Umair-Coder124/RoverBuddy-X1-verified/README.md

# RoverBuddy X1

RoverBuddy X1 is a design for a camera-guided companion robot. Four mecanum wheels let it drive sideways as well as forward and backward. A camera in the moving head is intended to track a person, and the chest display is intended to show status. The project combines computer vision, motion control and a custom chassis.

## CAD

[Open the latest Onshape revision](https://cad.onshape.com/documents/7af13938ef1c0698d1f50b49/w/3e6d69d20d18f8a901bda826/e/d6c90a986fc1453722e99382)

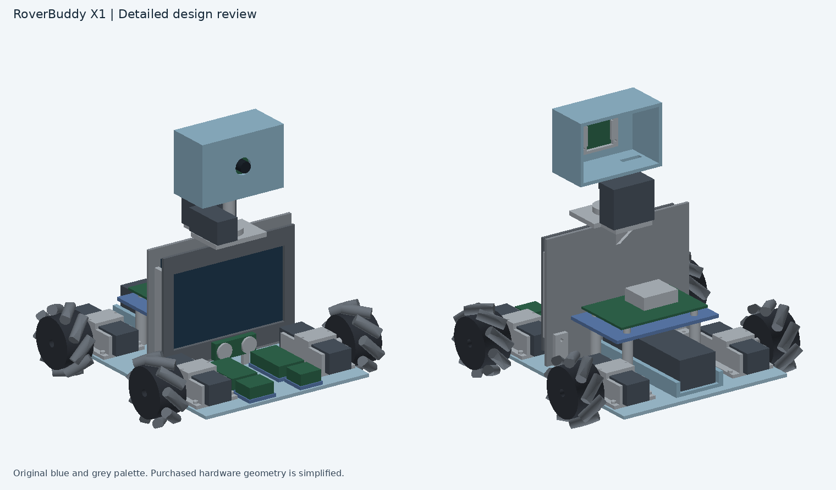
[picture p1: cad/Assembly_Preview.png]
Full CAD assembly from two angles


The [CAD notes](cad/README.md) describe the wheel and motor mounts, camera carrier and electronics placement. The full assembly STEP and 131 individual STEP files are in [cad](cad/). Purchased component envelopes are identified in the [parts manifest](cad/Parts_Manifest.csv). The STEP revision replaces `Roller_Rear_L_03` and `Roller_Front_R_03` with simplified representations of the purchased wheel rollers. The repaired import opened without the previously reported warnings in the project owner’s Onshape session. Hardware fit still needs confirmation.

## Wiring and intended use

```mermaid
flowchart LR
    BAT["3S battery"] --> PROT["Main fuse, disconnect and undervoltage protection"]
    PROT --> AUX["Separate Pi and servo supplies"]
    PROT --> STOP["Hardware motor cutoff"]
    STOP --> MOTOR["Independent front and rear 6 V motor supplies"]
```

Sophia confirmed that a wiring diagram is acceptable for this module-based design. See the [wiring draft](docs/WIRING.md) and [firmware instructions](firmware/README.md). Use the firmware simulator to try the drive logic. The intended physical workflow is to select a target through the camera system, then use the controller to command the four motors. Hardware testing and an end-to-end follow mode are pending.

## Design submission readiness

The drive controller passed five desktop tests and a simulated watchdog stop. The [serial parser fix](https://github.com/Umair-Coder124/RoverBuddy-X1-verified/commit/4406fdf8919625282004607cfbc282fbfebdae76) also passed a desktop check that an oversized line is discarded and the next valid line is accepted. Motor outputs are disabled by default.

- [x] Repaired Onshape tab loaded and rotated via the public link (confirmed by the project owner).
- [x] Check raised head and camera geometry against the imported pan-actuator envelope through ±180° in a separate CAD study. See the [fit result](docs/WIRING.md#raised-pan-adapter-fit-study).
- [ ] Finalize the shaft coupling and tilt mount, then check fastener access, connector clearance and camera ribbon travel in the assembled layout.
- [ ] Finalize the battery disconnect, hardware motor cutoff, fuse and servo supply ratings. Update the wiring and BOM together.
- [x] Reconcile the priced BOM lines to the provisional subtotal.
- [ ] Add exact links and costs for the selected power-protection hardware, identify the owned screwdrivers if possible, and confirm delivered costs.
- [ ] Confirm which AI-assisted CAD and firmware files, if any, Fallen accepts in the actual design submission. The organizer feedback reported so far addressed the wiring diagram and rollers.

## BOM and submission

The [Fallen BOM](bom.csv) requests **US$1,225.67** for 52 priced lines, including two matching batteries and one balance charger. Unit prices were converted at 3.75 SAR per USD and rounded before calculating line totals. The second battery is an offboard spare. The import excludes owned tools, parts included in other purchases, unpriced power-protection hardware and delivery. The [original cost estimates and item notes](https://github.com/Umair-Coder124/RoverBuddy-X1-verified/blob/92e4858a3a350e913623ddc59bf6ecd8bff52750/bom.csv) retain the SAR prices and pending items. Confirm pricing, stock and shipping before ordering. Battery protection, hardware isolation and bench validation remain open.

This is a review package with AI-assisted reference material. The [Fallen submission guide](https://fallen.hackclub.com/docs/submitting) calls for a finished entrant-designed digital project at the funding stage. Untested firmware is acceptable at that stage, and the physical build and demo are assessed at the build stage. Fallen's rules require entrants to design and document their own work. Ask the organizers whether any reference material can be reused, complete and document your own work, and check the submission requirements before sending the project for review.
