Umair-Coder124/RoverBuddy-X1-verified/cad/Drive_Corner.png

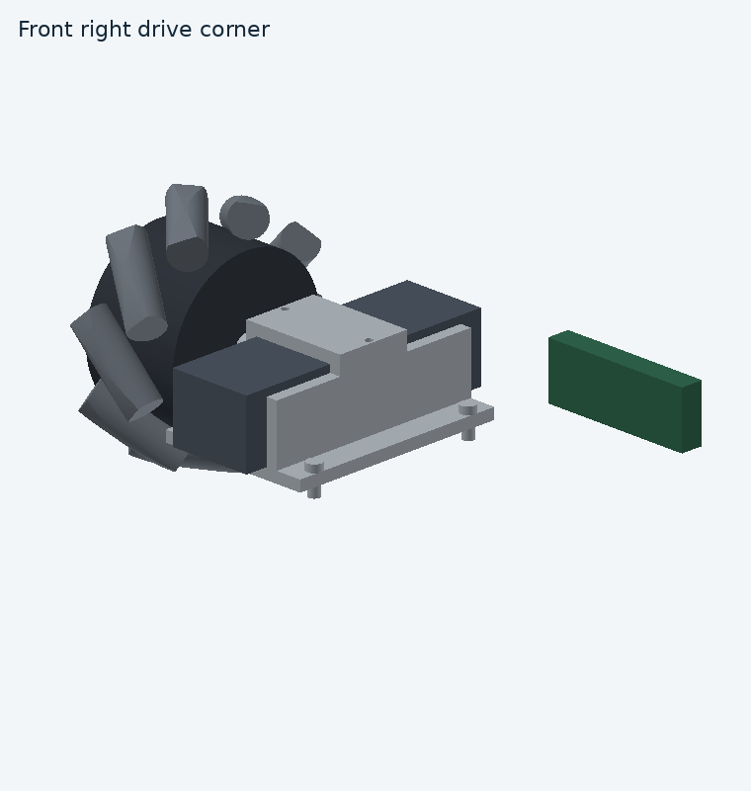
cad/Drive_Corner.png
