Umair-Coder124/RoverBuddy-X1-verified/cad/Head_Camera.png

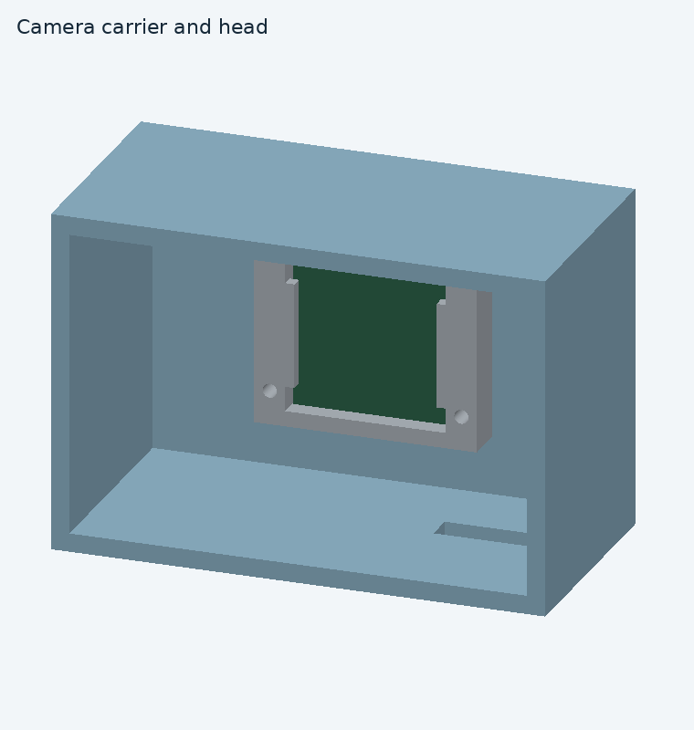
cad/Head_Camera.png
