Umair-Coder124/RoverBuddy-X1-verified/bom.csv

Item | Quantity | Unit Price | Total | Link | Description
Raspberry Pi 5 4GB kit incl official 27W PSU, active cooler, HDMI lead and case | 1 | 175.81 | 175.81 | https://geeksvalley.com/product/raspberry-pi-5-4gb-kit/ | Pi computer for on-device AI; official PSU for mains testing; included cooler and HDMI cable avoid duplicate funding.
SanDisk Extreme A2 microSDXC 64GB SDSQXAH-064G-GN6MN | 1 | 36.83 | 36.83 | https://pcpark.sa/en/collections/flash/products/sandisk-sdsqxah-064g-gn6mn | Operating system and camera software; no reliable in-stock exact product page verified
Raspberry Pi Pico 2 with Headers (SC1632) | 1 | 6.00 | 6.00 | https://www.digikey.com/en/products/detail/raspberry-pi/SC1632/26241102 | Controller with manufacturer-documented pinout
USB-A to Micro-B USB 2.0 data cable 0.5 m | 1 | 2.67 | 2.67 | https://ielectrony.com/en/product/micro-usb-cable-0-5m/ | Pi-to-Pico USB data and controller programming
Raspberry Pi Camera Module 3, Sony IMX708, standard lens | 1 | 52.00 | 52.00 | https://saudi.microless.com/product/raspberry-pi-camera-module-3-standard-sony-imx708-sensor-11-9mp-resolution-7-4mm-sensor-diagonal-f-1-8-aperture-phase-dete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 | People tracking and obstacle perception in head
Pi 5 camera cable 22pin-to-15pin 300mm | 1 | 8.00 | 8.00 | https://ielectrony.com/en/product/official-raspberry-pi-csi-fpc-flexible-cable-300mm-22pin-to-15pin-camera-cable/ | Required Pi 5 adapter ribbon; only buy 300mm if measured head-to-Pi routing fits
Waveshare 20109 5inch HDMI LCD (H) V4 capacitive USB touch display | 1 | 50.99 | 50.99 | https://www.waveshare.com/product/5inch-hdmi-lcd-h-v4.htm | Driver-free USB touch avoids the old screen GPIO touch driver uncertainty on Pi 5; uses no GPIO for touch.
Mini external USB stereo speaker for Raspberry Pi greeting audio | 1 | 7.33 | 7.33 | https://ielectrony.com/en/product/mini-external-usb-stereo-speaker/ | Pi 5 compatible USB greeting audio; previous 3.5mm concern resolved by supplier specification.
Adafruit 3777 TT DC gearbox motor 1:48, 3-6V, supplied 200mm leads | 4 | 2.95 | 11.80 | https://www.adafruit.com/product/3777 | Four independently driven TT motors with published electrical measurements; replaces ambiguous bundled-motor claim.
Cytron MDD3A dual brushed DC motor driver, 3A continuous per channel | 2 | 9.30 | 18.60 | https://www.cytron.io/c-dc-motor/c-motor-driver/p-3amp-4v-16v-dc-motor-driver-2-channels | Replaces TB6612FNG with more continuous current margin and retains separate control for every mecanum wheel.
HC-SR04 ultrasonic obstacle sensor | 1 | 6.13 | 6.13 | https://ielectrony.com/en/product/%D8%AD%D8%B3%D8%A7%D8%B3-%D8%A7%D9%84%D8%AA%D8%B1%D8%A7-%D8%B3%D9%88%D9%86%D9%8A%D9%83-hc-sr04/ | Forward distance sensing
1kΩ 1/4W 1% resistor for HC-SR04 ECHO 5V-to-3.3V divider | 1 | 0.13 | 0.13 | https://ielectrony.com/en/product/%D8%B9%D8%AF%D8%AF-1-%D9%85%D9%82%D8%A7%D9%88%D9%85%D8%A9-1k-ohm-1-4w/ | Prevent 5V ultrasonic echo damaging 3.3V logic; resistor pair only (avoid I2C-only level shifter)
2kΩ 1/4W 1% resistor for HC-SR04 ECHO 5V-to-3.3V divider | 1 | 0.13 | 0.13 | https://ielectrony.com/en/product/%D8%B9%D8%AF%D8%AF-1-%D9%85%D9%82%D8%A7%D9%88%D9%85%D8%A9-2k-ohm-1-4w/ | Prevent 5V ultrasonic echo damaging 3.3V logic; resistor pair only (avoid I2C-only level shifter)
DFRobot FIT0765 black 60mm LEFT mecanum wheel with coupling | 2 | 6.90 | 13.80 | https://www.dfrobot.com/product-2268.html | Separate wheel selection removes ambiguous bundle contents; hardware roller layout must follow maker diagram.
DFRobot FIT0766 black 60mm RIGHT mecanum wheel with coupling | 2 | 6.90 | 13.80 | https://www.dfrobot.com/product-2269.html | Four total mecanum wheels, two handed pairs, not four identical wheels.
One aluminium 2-axis standard-servo pan/tilt bracket kit incl pivot bearing and metal fittings | 1 | 17.33 | 17.33 | https://www.mikroelectron.com/product/me-603 | All-metal load-bearing bracket and supported pivot; metal gears alone do not mean all-metal servo housing.
TD8120MG 20kg.cm 180° positional high-torque servo for PAN | 1 | 18.40 | 18.40 | https://qariya.net/en/product/servo-motor-20kg-torque-td8120mg-tiankongrc-180-degree/ | Strong metal-geared servo; rotates whole head left/right
TD8120MG 20kg.cm 180° positional high-torque servo for TILT | 1 | 18.40 | 18.40 | https://qariya.net/en/product/servo-motor-20kg-torque-td8120mg-tiankongrc-180-degree/ | Tilts complete head up/down
Pololu 2184 servo extension cable, 300mm, 22AWG, JR/Futaba male-female | 2 | 4.64 | 9.28 | https://www.pololu.com/product/2184/specs | Allows full head movement without straining servo wiring; verify cable flex life
25T aluminium clamp servo horn, black, ONE per servo if required | 2 | 4.00 | 8.00 | https://www.noon.com/saudi-en/25t-metal-servo-horn-compatible-with-futaba-upgrade-part-for-sakura-d4-drift-crawler-rc-cars-cnc-high-precision-aluminum-alloy-m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 | HOLD: TD8120MG spline and required bracket horn geometry not verified. 25T is a candidate, not confirmed fit. Remove duplicate cost if matching metal horns are supplied; verify ETA before order.
Venom 15190 preassembled 3S 11.1V 2200mAh 50C LiPo, UNI 2.0 adapter system | 2 | 84.00 | 168.00 | https://hobby-rc.net/product/بطارية-venom-50c-3s-2200mah-11-1v-lipo/ | 3S gives headroom above Pi power board 7V minimum and 6V buck regulator dropout; avoids the old 2S low-voltage mismatch.
SkyRC S100neo SK-100202 AC/DC balance charger with storage mode | 1 | 116.53 | 116.53 | https://hobbysportzksa.com/en-sa/products/sky-rc-s100neo-ac-dc-charger-item-no-sk-100202 | Documented chemistry/cell-count support and storage function; price is higher than the unverified SAR 120 allowance.
LiPo battery storage/charging bag, flame-retardant glass-fiber pouch, 10x20cm | 1 | 7.47 | 7.47 | https://www.noon.com/saudi-en/lipo-battery-safe-bag-210d-high-grade-fire-retardant-material-explosion-proof-high-temperature-resistant-lipo-charging-sack-for-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 | Safer charging/storage with adult oversight; fireproof claims not guaranteed; verify certified seller listing
20cm reusable LiPo retention strap, TWO individual straps | 2 | 2.40 | 4.80 | https://www.pixelelectric.com/drones-parts/drone-assembly-parts/accessories/rc-battery-belt-strap-cable-tie/ | Secures pack in printed tray without crushing cells
Locking emergency-stop push button LAY37, 10A thermal rating (DC rating TBC) | 1 | 2.80 | 2.80 | https://ielectrony.com/en/product/660vac-10a-dpst-emergency-stop-push-button-switch/ | Accessible drive cutout when movement unsafe
DC-rated main power switch matched to measured maximum current | 1 | 2.67 | 2.67 | https://ielectrony.com/en/product/symfonia-ad2212-round-push-button-12v-on-off-power-switch-suitable-for-10a250vac-20a12vdc/ | Robot power isolation; verify DC interrupt rating at full pack voltage and inrush
RS PRO 237-5266 inline ATO blade fuse holder, 32V, 15A holder, 16AWG leads | 1 | 10.23 | 10.23 | https://sa.rsdelivers.com/product/rs-pro/rs-pro-15-a-in-line-fuse-holder-32-v/2375266?backToResults=1 | Protect main battery feed, place near positive terminal; source direct item page needed
Littelfuse 0287010.PXCN ATOF 10A 32VDC fuse; one installed plus one spare | 2 | 0.35 | 0.70 | https://www.digikey.com/en/products/detail/littelfuse-inc/0287010-PXCN/2519807 | Named DC fuse candidate rather than unspecified 20A fuse; protects battery feed subject to current coordination.
Yahboom YB-MPP01-V1.0 Pi 5 PD power board, 7-24V input for 5V/5A | 1 | 25.00 | 25.00 | https://geekworm.com/products/yb-mpp01 | Purpose-built Pi 5 power negotiation; no unsupported claim that any 5A USB-C lead negotiates 5V/5A.
Pololu 6V 5.5A switching regulator D36V50F6 for head servos | 1 | 39.95 | 39.95 | https://www.pololu.com/product/4092 | Separate servo 6V supply prevents Pi resets
Pololu D36V50F6 6 V regulator, one per motor driver | 2 | 39.95 | 79.90 | https://www.pololu.com/product/4092 | Independent front and rear motor rails
Safa SKU1690 XT60 male/female connector cable pair | 1 | 9.33 | 9.33 | https://www.safaelectronics.com/product/xt60-connector-with-cable-mf | Prevent reverse-polarity and allow unplugging battery; seller to confirm actual battery connector
WAGO 221-415 5-way lever connectors, one pack of 10 (use separate + and - nodes) | 1 | 17.79 | 17.79 | https://my.rs-online.com/web/p/standard-terminal-blocks/8837557 | Named insulated distribution hardware replaces unspecified bare solder bus and avoids undersized signal terminal use.
TW21 twin flexible copper PVC cable 2 x 1.0mm2, three one-metre lengths | 3 | 0.33 | 0.99 | https://ielectrony.com/product/%D8%B3%D9%84%D9%83-%D9%85%D8%B2%D8%AF%D9%88%D8%AC-%D9%85%D8%B3%D8%B7%D8%AD-%D9%88%D9%85%D8%B9%D8%B2%D9%88%D9%84-pvc-2x-1-0-mm/ | Locally listed minimum-length power wiring; verify ampacity rather than infer it from a wire size alone.
Silicone 22AWG flexible signal and motor hookup wire about 2m each color | 1 | 21.07 | 21.07 | https://ielectrony.com/en/product/22awg-6-colors-mix-kit-electrical-wire-copper-wire-for-diy/ | Low-current controller, servo signal and sensor wiring
40 x 20cm male-to-female Dupont jumper wires | 1 | 5.33 | 5.33 | https://ielectrony.com/en/product/%D8%B9%D8%AF%D8%AF-40-%D8%B3%D9%84%D9%83-%D8%B3%D9%84%D9%83-%D8%B0%D9%83%D8%B1-%D8%A7%D9%86%D8%AB%D9%89-20-%D8%B3%D9%85/ | Prototyping and controller wiring; not for high-current supply
40 x 20cm female-to-female Dupont jumper wires | 1 | 5.33 | 5.33 | https://ielectrony.com/en/product/%D8%B9%D8%AF%D8%AF-40-%D8%B3%D9%84%D9%83-%D8%A7%D9%86%D8%AB%D9%89-%D8%A7%D9%86%D8%AB%D9%89-20-%D8%B3%D9%85/ | Pico GPIO and low-current modules; not motor power
2pcs insulated 18AWG female spade terminal leads 30cm | 1 | 2.67 | 2.67 | https://ielectrony.com/en/product/6-3mm-female-spade-crimp-terminal-with-insulating-sleeve-and-300mm-red-and-black-wires/ | Power switch/stop lug wiring only if 6.3mm tab switch selected; check fit
5x7cm solderable copper prototyping perfboard | 1 | 2.27 | 2.27 | https://ielectrony.com/en/product/57-cm-universal-pcb-board/ | Mount basic signal interface and resistors (not custom MCU PCB)
Heat shrink insulation tubing 4mm x 1m | 1 | 1.20 | 1.20 | https://ielectrony.com/en/product/heat-shrink-tubing-4mm-black-1-meter/ | Insulate small solder joints
Heat shrink insulation tubing 8mm x 1m | 1 | 1.87 | 1.87 | https://ielectrony.com/en/product/heat-shrink-tubing-8mm-black-1-meter/ | Insulate large cable terminations
Nylon cable ties, 5-piece pack 292 x 3.6mm; TWO packs | 2 | 0.40 | 0.80 | https://ielectrony.com/en/product/nylon-tie-292x3-6mm/ | Cable routing away from gears/wheels
TAC Z-BG-F8 open grommet 8mm, four pieces | 4 | 0.07 | 0.28 | https://electrotel.sa/products/tac-grommet-open | Protect cables at enclosure exits; printed secured guides supply strain relief.
200-piece M3/M2.5 brass standoff / nuts / screws robot hardware kit | 1 | 15.07 | 15.07 | https://ielectrony.com/en/product/200pcs-screw-kit-for-robot-accessories/ | Includes Pi standoffs and many body fasteners; eliminates separate M2.5 and M3 assorted packs
M2x10 camera mounting screws, pack of 5; matching captive nuts INCLUDED in print-service quote request | 1 | 0.27 | 0.27 | https://ielectrony.com/en/product/m2x10-304-stainless-steel-cross-recessed-pan-head-phillips-screws-5pcs/ | Camera Module 3 uses small fasteners; confirm M2 vs M2.5 mounting hole
M3x20 stainless nonpointed bolts pack of 5 | 1 | 0.31 | 0.31 | https://ielectrony.com/en/product/m3x20-bolt-non-pointed-5pcs/ | Only if exact head/chest print mounts require 20mm thread length
PETG printing, cleanup, inserts, M2 nuts and screw-down cable guides for final verified CAD parts | 1 | 146.67 | 146.67 | https://omq3d.com/en/pricing.html | One scoped fabrication service, including fastener finishing; outsourced printing preserves custom chassis and avoids printer/filament purchase.
UNI-T UT33A+ digital multimeter | 1 | 22.67 | 22.67 | https://ielectrony.com/en/product/digital-multimeter-ut33a/ | Continuity, regulator output voltage, polarity and wiring safety
NEBCO clear OTG safety glasses, seller claims EN166 | 1 | 1.47 | 1.47 | https://nebcoksa.com/en/otg-safety-glasses/p99230678 | Eye protection during snipping/soldering; exact seller page required
30x20cm heat-insulating silicone soldering work mat | 1 | 6.67 | 6.67 | https://ielectrony.com/en/product/heat-insulation-silicone-working-mat-3020cm/ | Protect desk from hot iron; remove if a proper metal/ceramic surface already available
Compact basic 1.5mm/2mm/2.5mm/3mm Allen key set | 1 | 4.00 | 4.00 | https://ielectrony.com/product/%D9%85%D9%81%D8%A7%D8%AA%D9%8A%D8%AD-%D8%B3%D8%AF%D8%A7%D8%B3%D9%8A%D8%A9-%D8%A7%D9%84%D9%8A%D9%86/ | Fit motor/servo fasteners; user has plus/minus screwdriver only
Adjustable 60W soldering kit with iron, stand, solder, wire stripper/cutter, tips, pump, sponge and tweezers | 1 | 26.13 | 26.13 | https://ielectrony.com/en/product/useful-220v-60w-uk-plug-soldering-handy-kit/ | One inexpensive kit replaces several tools; meets Fallen minimum-tool principle.
