Umair-Coder124/RoverBuddy-X1-verified/cad/RoverBuddy_X1_Detailed_Assembly.step

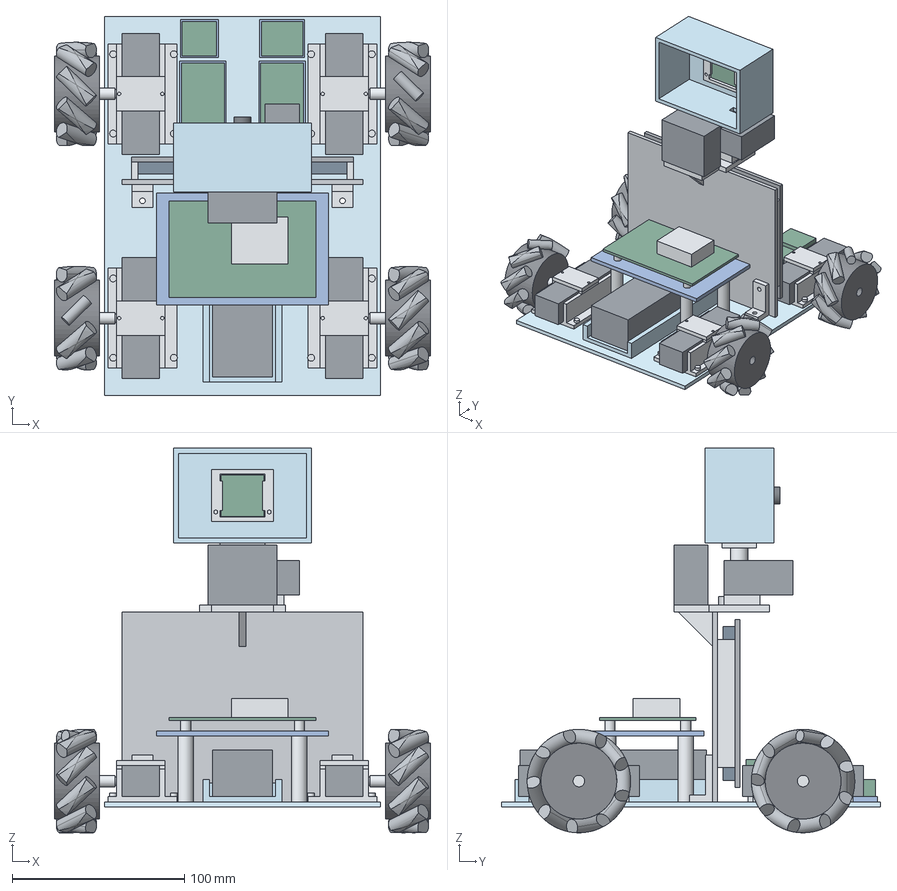
[picture p4: CAD file, 2026-11-13]
cad/RoverBuddy_X1_Detailed_Assembly.step
218.0 x 220.0 x 223.0 mm
02_Chest_Panel_140x110x3
04_Neck_Base_Plate_50x35x4
05_Single_Concept_Gusset_4mm
09_Obstacle_Sensor_Front_Reference
Ultrasonic_Transducer_-12
Ultrasonic_Transducer_12
10_Neck_Pan_Axis_Bearing_Concept
Neck_Pan_Axis_Placeholder
Cradle_Base_Screw_Front_L_39.8_42
Cradle_Base_Screw_Front_L_39.8_88
Cradle_Base_Screw_Front_L_75_42
Cradle_Base_Screw_Front_L_75_88
Motor_Cradle_Front_L
Motor_3777_Envelope_Front_L
Cradle_Cap_Post_Front_L_46.5
Cradle_Cap_Post_Front_L_71.5
Motor_Cradle_Cap_Front_L
Motor_Shaft_Reference_Front_L
Supplied_Coupling_Reference_Front_L
Mecanum_Wheel_Hub_Front_L
Roller_Front_L_01
Roller_Front_L_02
Roller_Front_L_03
Roller_Front_L_04
Roller_Front_L_05
Roller_Front_L_06
Roller_Front_L_07
Roller_Front_L_08
Roller_Front_L_09
Cradle_Base_Screw_Rear_L_39.8_-88
Cradle_Base_Screw_Rear_L_39.8_-42
Cradle_Base_Screw_Rear_L_75_-88
Cradle_Base_Screw_Rear_L_75_-42
Motor_Cradle_Rear_L
Motor_3777_Envelope_Rear_L
Cradle_Cap_Post_Rear_L_46.5
Cradle_Cap_Post_Rear_L_71.5
Motor_Cradle_Cap_Rear_L
Motor_Shaft_Reference_Rear_L
Supplied_Coupling_Reference_Rear_L
Mecanum_Wheel_Hub_Rear_L
Roller_Rear_L_01
Roller_Rear_L_02
Roller_Rear_L_03
Roller_Rear_L_04
Roller_Rear_L_05
Roller_Rear_L_06
Roller_Rear_L_07
Roller_Rear_L_08
Roller_Rear_L_09
Cradle_Base_Screw_Front_R_39.8_42
Cradle_Base_Screw_Front_R_39.8_88
Cradle_Base_Screw_Front_R_75_42
Cradle_Base_Screw_Front_R_75_88
Motor_Cradle_Front_R
Motor_3777_Envelope_Front_R
Cradle_Cap_Post_Front_R_46.5
Cradle_Cap_Post_Front_R_71.5
Motor_Cradle_Cap_Front_R
Motor_Shaft_Reference_Front_R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
