Umair-Coder124/RoverBuddy-X1-verified/cad/parts/Roller_Front_R_03.step

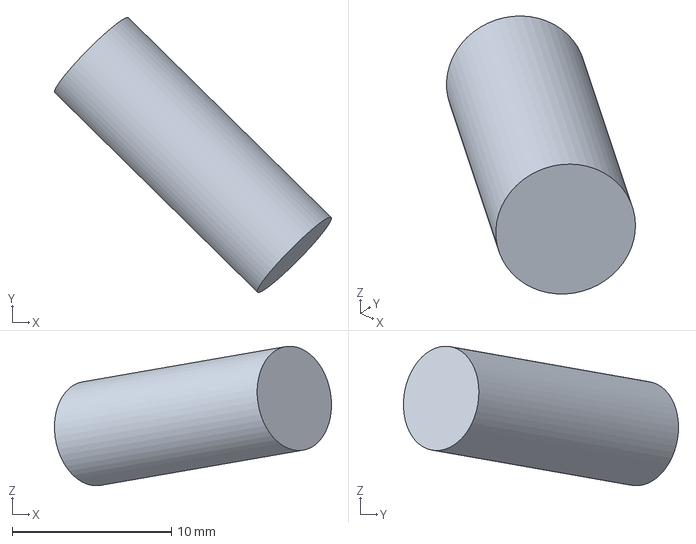
[picture p5: CAD file, 2026-11-13]
cad/parts/Roller_Front_R_03.step
17.4 x 17.3 x 8.76 mm
