Umair-Coder124/RoverBuddy-X1-verified/cad/parts/Motor_3777_Envelope_Front_L.step

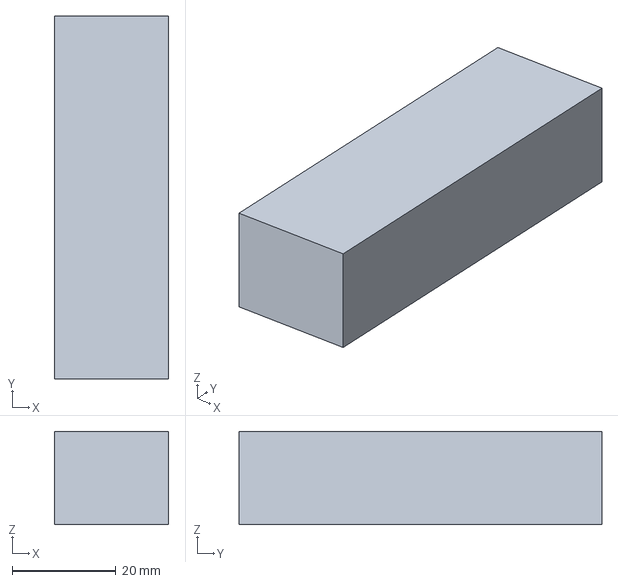
[picture p6: CAD file, 2026-11-13]
cad/parts/Motor_3777_Envelope_Front_L.step
22.0 x 70.0 x 18.0 mm
