Umair-Coder124/RoverBuddy-X1-verified/cad/parts/Motor_Cradle_Rear_L.step

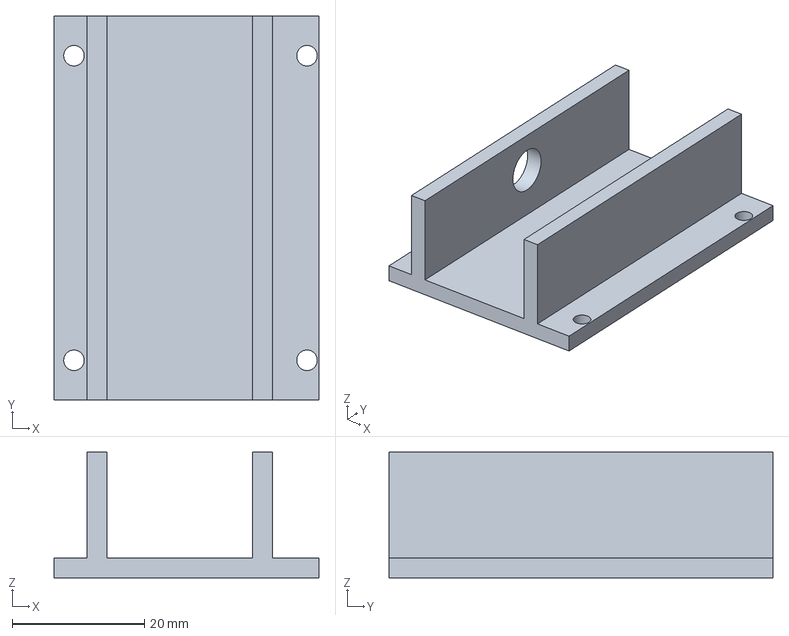
[picture p7: CAD file, 2026-11-13]
cad/parts/Motor_Cradle_Rear_L.step
40.0 x 58.0 x 19.0 mm
