Umair-Coder124/RoverBuddy-X1-verified/cad/parts/Tilt_Servo_Envelope.step

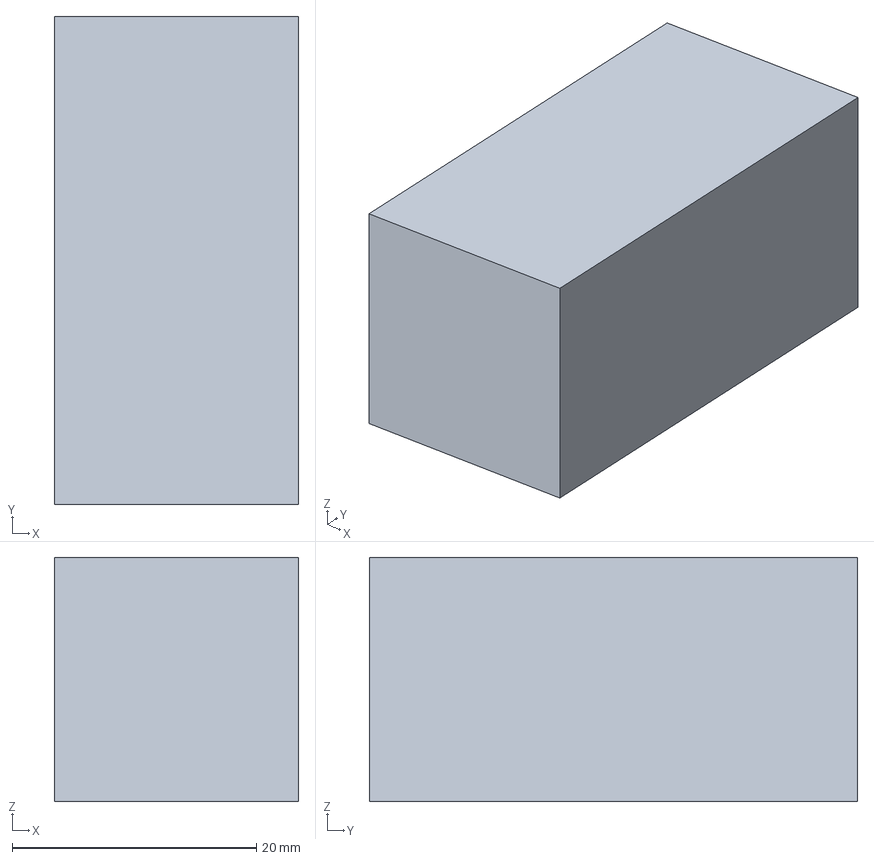
[picture p8: CAD file, 2026-11-13]
cad/parts/Tilt_Servo_Envelope.step
20.0 x 40.0 x 20.0 mm
