Umair-Coder124/RoverBuddy-X1-verified/cad/parts/Pi_Tray_100_Raised.step

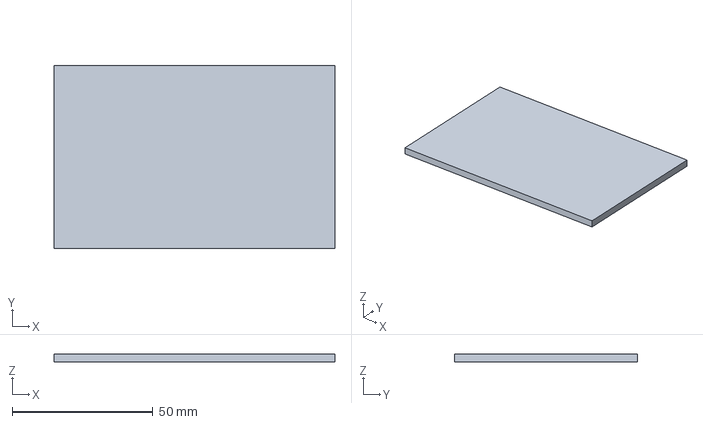
[picture p9: CAD file, 2026-11-13]
cad/parts/Pi_Tray_100_Raised.step
100.0 x 65.0 x 3.00 mm
