Umair-Coder124/RoverBuddy-X1-verified/cad/parts/Battery_108x35x27_Envelope.step

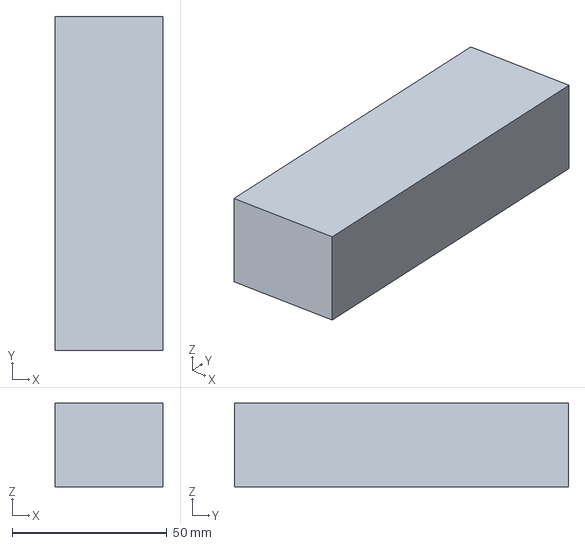
[picture p10: CAD file, 2026-11-13]
cad/parts/Battery_108x35x27_Envelope.step
35.0 x 108.0 x 27.0 mm
