Umair-Coder124/RoverBuddy-X1-verified/cad/parts/Mecanum_Wheel_Hub_Front_R.step

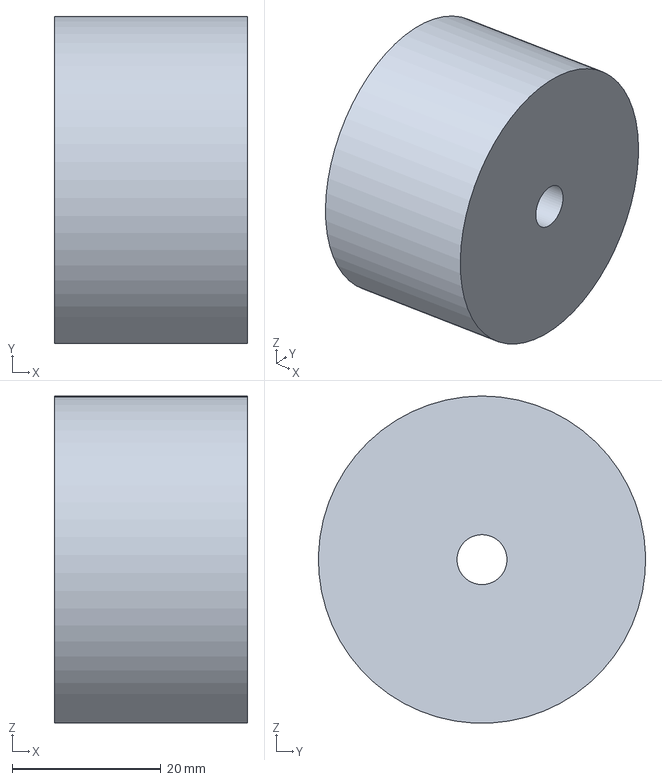
[picture p11: CAD file, 2026-11-13]
cad/parts/Mecanum_Wheel_Hub_Front_R.step
26.0 x 44.0 x 44.0 mm
