Umair-Coder124/RoverBuddy-X1-verified/cad/parts/Roller_Front_L_06.step

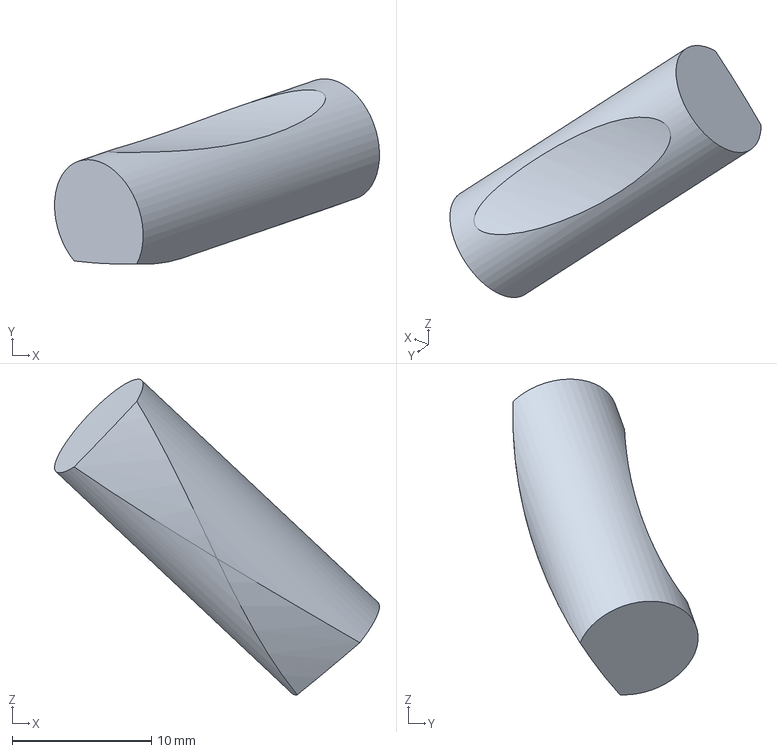
[picture p12: CAD file, 2026-11-13]
cad/parts/Roller_Front_L_06.step
23.3 x 13.3 x 22.7 mm
