Umair-Coder124/RoverBuddy-X1-verified/cad/parts/Pi5_Cooler_Envelope.step

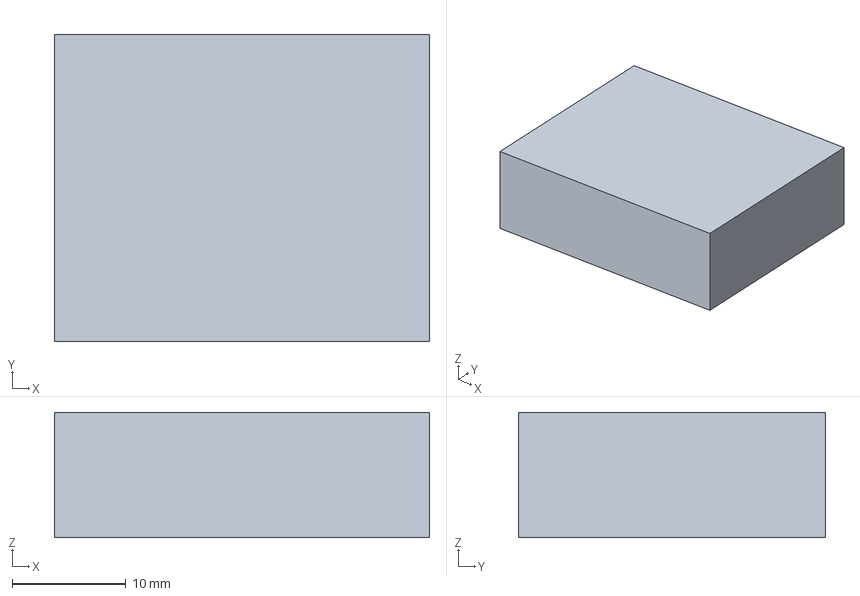
[picture p13: CAD file, 2026-11-13]
cad/parts/Pi5_Cooler_Envelope.step
33.0 x 27.0 x 11.0 mm
