Umair-Coder124/RoverBuddy-X1-verified/cad/parts/Neck_Pan_Axis_Placeholder.step

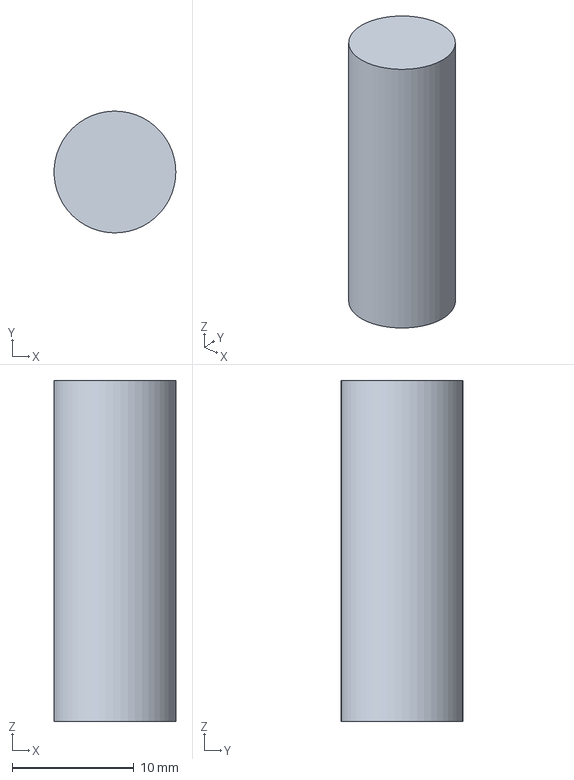
[picture p14: CAD file, 2026-11-13]
cad/parts/Neck_Pan_Axis_Placeholder.step
9.99 x 10.00 x 28.0 mm
