Umair-Coder124/RoverBuddy-X1-verified/cad/parts/Pi_Board_Spacer_-33_-47.step

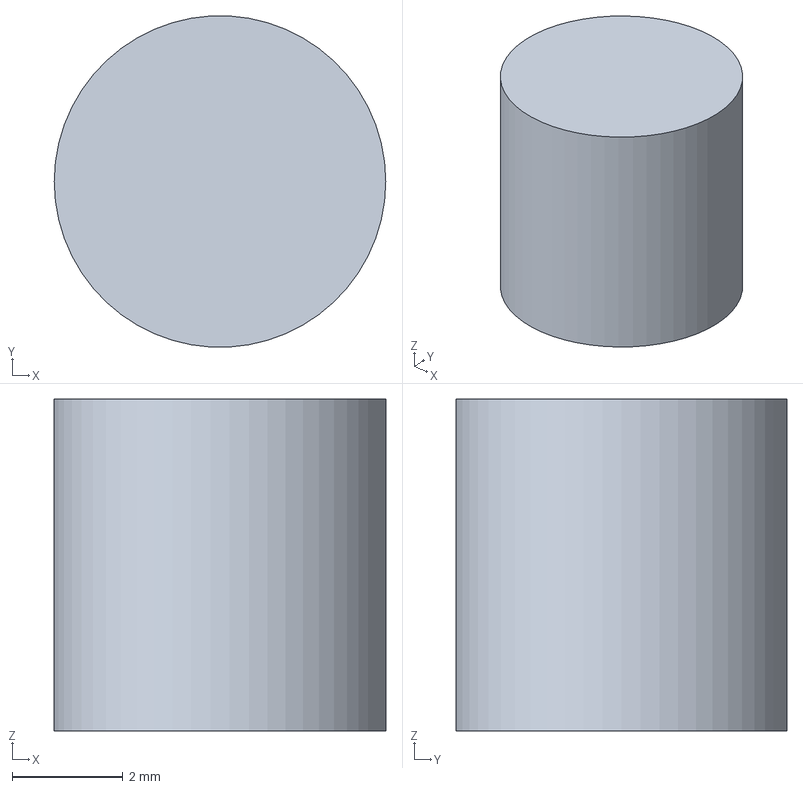
[picture p15: CAD file, 2026-11-13]
cad/parts/Pi_Board_Spacer_-33_-47.step
6.00 x 5.99 x 6.00 mm
