Umair-Coder124/RoverBuddy-X1-verified/cad/parts/Roller_Rear_L_08.step

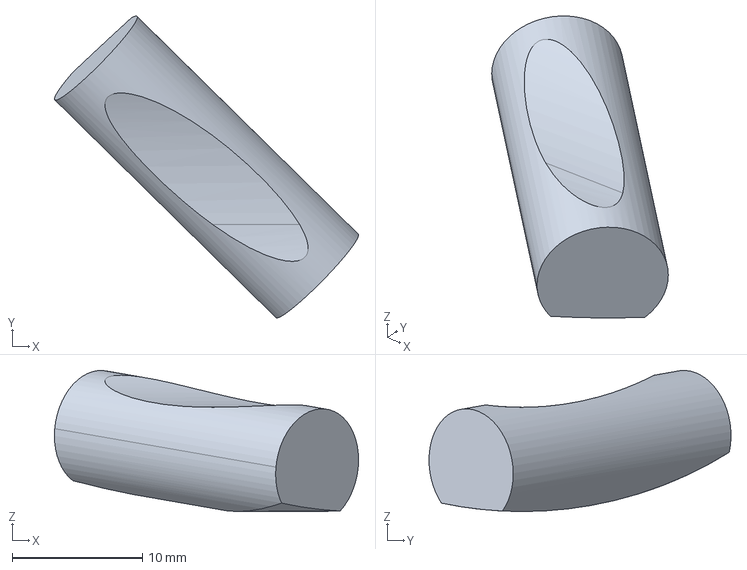
[picture p16: CAD file, 2026-11-13]
cad/parts/Roller_Rear_L_08.step
23.3 x 23.2 x 10.8 mm
