Umair-Coder124/RoverBuddy-X1-verified/cad/parts/02_Chest_Panel_140x110x3.step

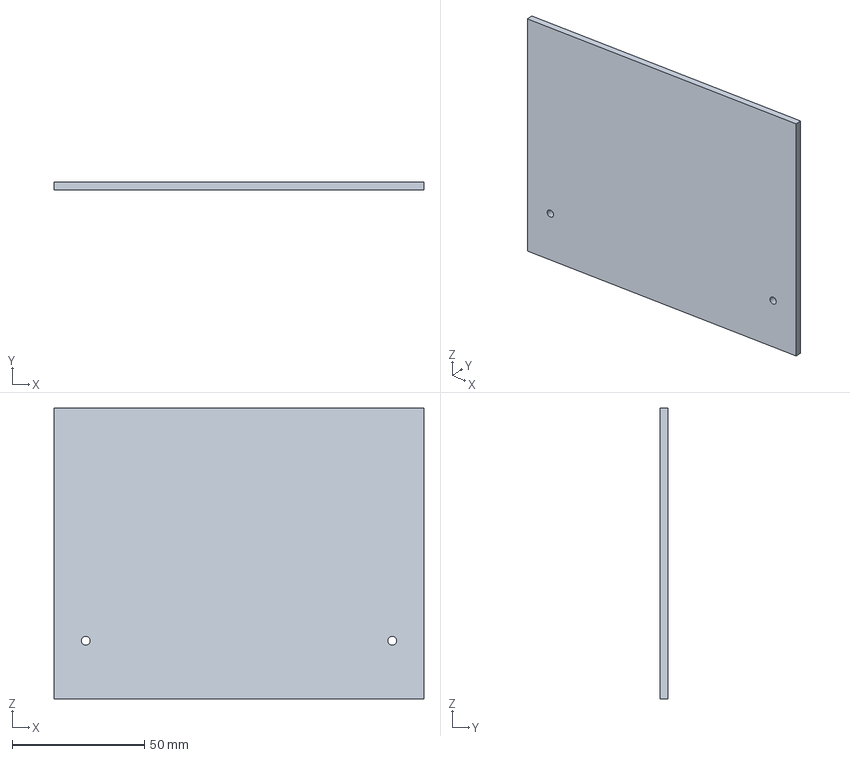
[picture p17: CAD file, 2026-11-13]
cad/parts/02_Chest_Panel_140x110x3.step
140.0 x 3.00 x 110.0 mm
