Umair-Coder124/RoverBuddy-X1-verified/cad/parts/Roller_Rear_R_09.step

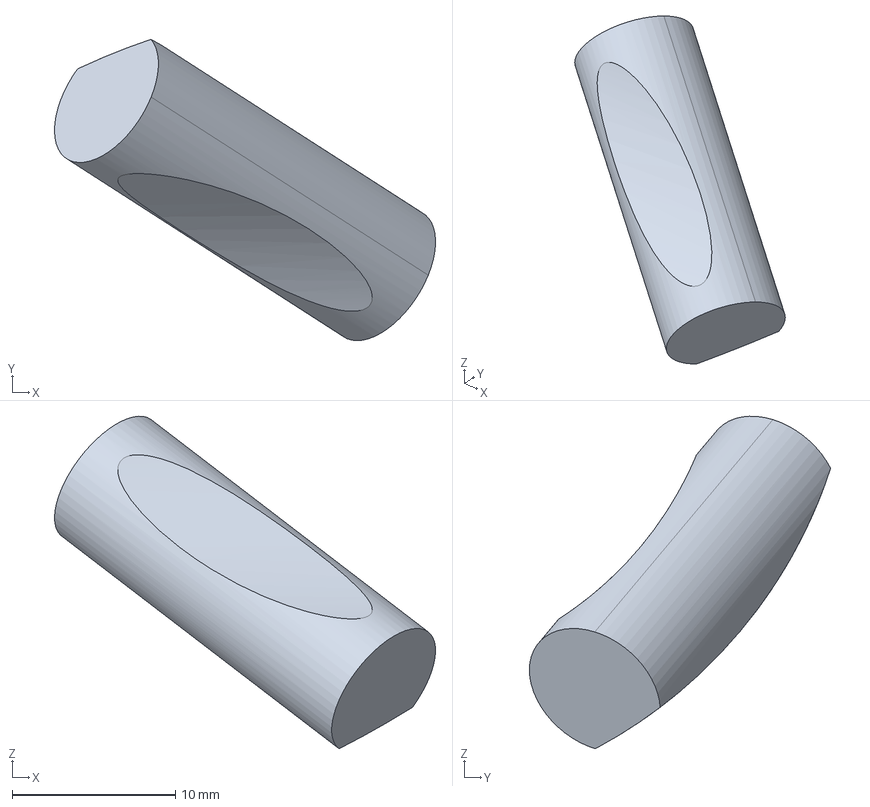
[picture p18: CAD file, 2026-11-13]
cad/parts/Roller_Rear_R_09.step
23.3 x 18.5 x 20.4 mm
