Umair-Coder124/RoverBuddy-X1-verified/cad/parts/Display_Bezel_Service_Frame.step

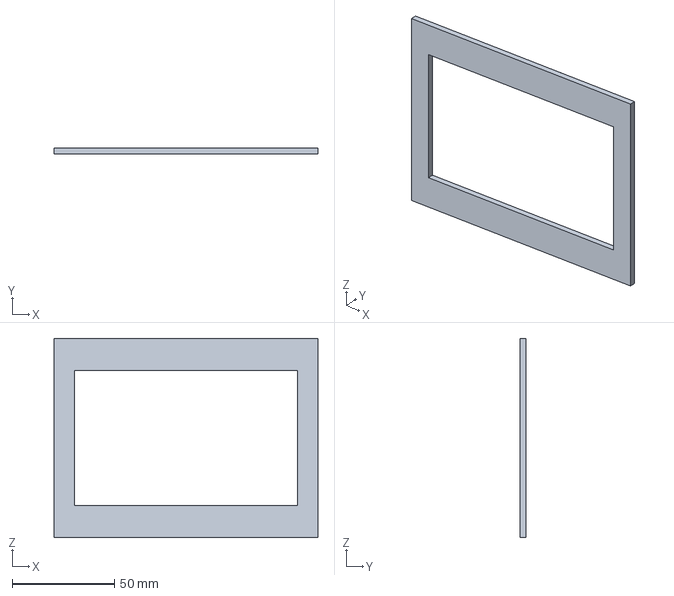
[picture p19: CAD file, 2026-11-13]
cad/parts/Display_Bezel_Service_Frame.step
129.0 x 3.00 x 97.5 mm
