Umair-Coder124/RoverBuddy-X1-verified/cad/parts/Roller_Rear_R_07.step

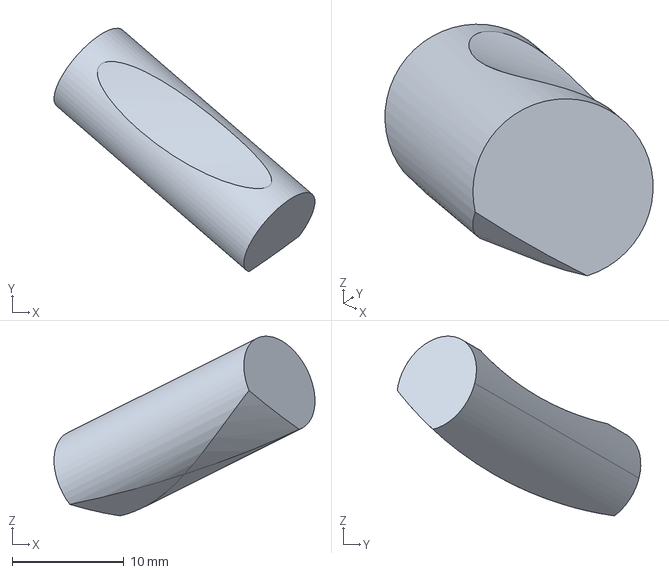
[picture p20: CAD file, 2026-11-13]
cad/parts/Roller_Rear_R_07.step
23.3 x 21.8 x 16.1 mm
