Umair-Coder124/RoverBuddy-X1-verified/cad/parts/Chest_Base_Bracket_-58.step

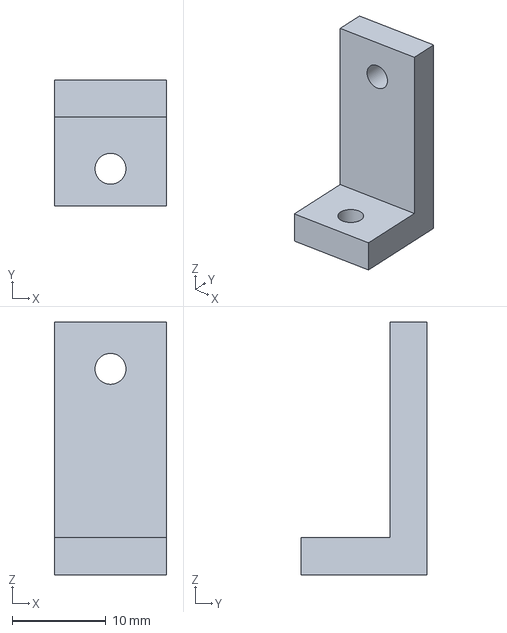
[picture p21: CAD file, 2026-11-13]
cad/parts/Chest_Base_Bracket_-58.step
12.0 x 13.5 x 27.0 mm
