Umair-Coder124/RoverBuddy-X1-verified/cad/parts/Motor_Cradle_Cap_Rear_L.step

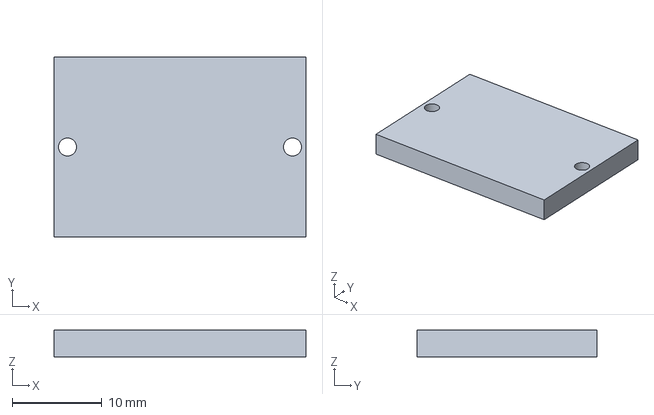
[picture p22: CAD file, 2026-11-13]
cad/parts/Motor_Cradle_Cap_Rear_L.step
28.0 x 20.0 x 3.00 mm
