Umair-Coder124/RoverBuddy-X1-verified/cad/parts/Power_Distribution_Foot.step

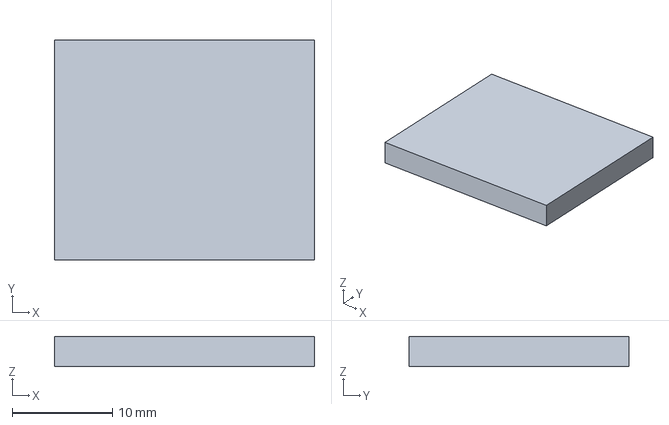
[picture p23: CAD file, 2026-11-13]
cad/parts/Power_Distribution_Foot.step
26.0 x 22.0 x 3.00 mm
