Umair-Coder124/RoverBuddy-X1-verified/cad/parts/Power_Distribution_Envelope.step

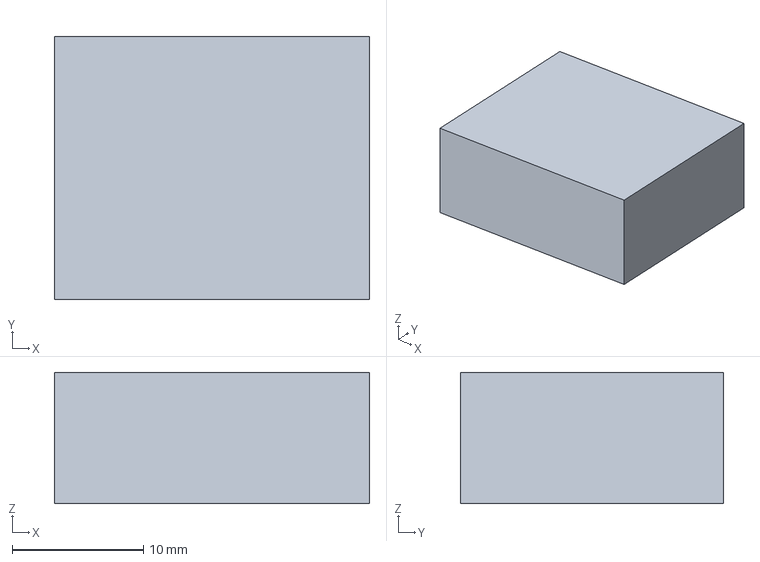
[picture p24: CAD file, 2026-11-13]
cad/parts/Power_Distribution_Envelope.step
24.0 x 20.0 x 10.0 mm
