Umair-Coder124/RoverBuddy-X1-verified/cad/parts/Driver_Left_Foot.step

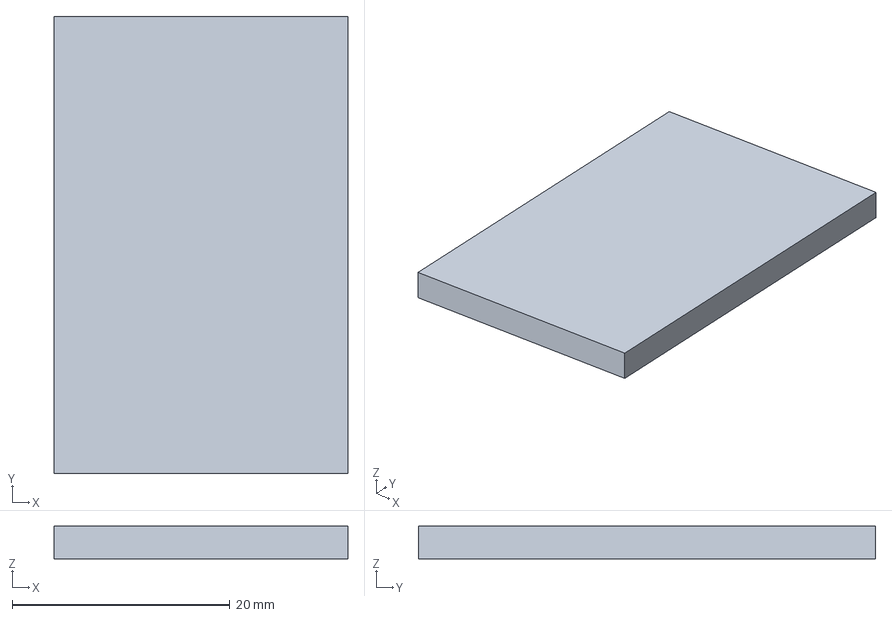
[picture p25: CAD file, 2026-11-13]
cad/parts/Driver_Left_Foot.step
27.0 x 42.0 x 3.00 mm
