Umair-Coder124/RoverBuddy-X1-verified/cad/parts/Motor_Shaft_Reference_Front_R.step

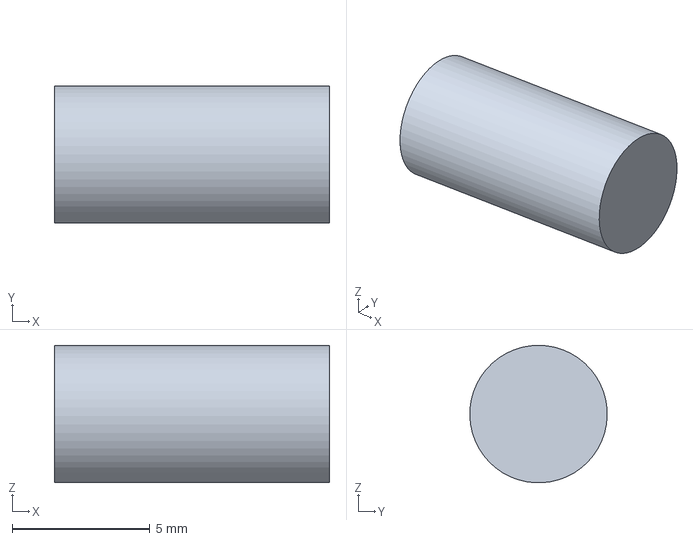
[picture p26: CAD file, 2026-11-13]
cad/parts/Motor_Shaft_Reference_Front_R.step
10.0 x 5.00 x 5.00 mm
