Umair-Coder124/RoverBuddy-X1-verified/cad/parts/Camera_Carrier_Frame.step

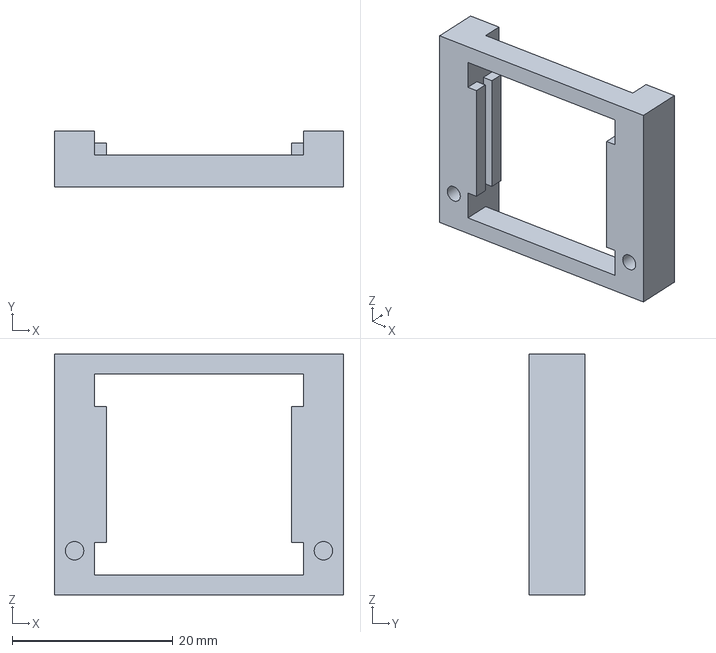
[picture p27: CAD file, 2026-11-13]
cad/parts/Camera_Carrier_Frame.step
36.0 x 7.00 x 30.0 mm
