Umair-Coder124/RoverBuddy-X1-verified/cad/parts/Supplied_Coupling_Reference_Front_L.step

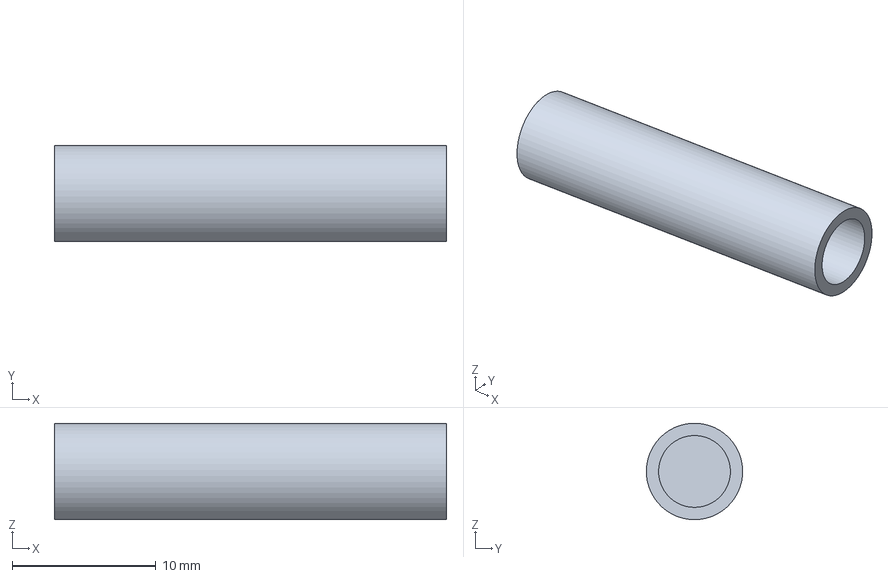
[picture p28: CAD file, 2026-11-13]
cad/parts/Supplied_Coupling_Reference_Front_L.step
27.3 x 6.71 x 6.70 mm
