Umair-Coder124/RoverBuddy-X1-verified/cad/parts/10_Neck_Pan_Axis_Bearing_Concept.step

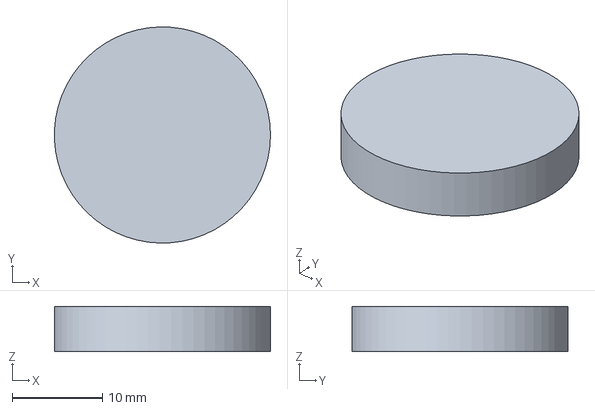
[picture p29: CAD file, 2026-11-13]
cad/parts/10_Neck_Pan_Axis_Bearing_Concept.step
24.0 x 24.0 x 5.00 mm
