Umair-Coder124/RoverBuddy-X1-verified/cad/parts/Camera_Lens_Envelope.step

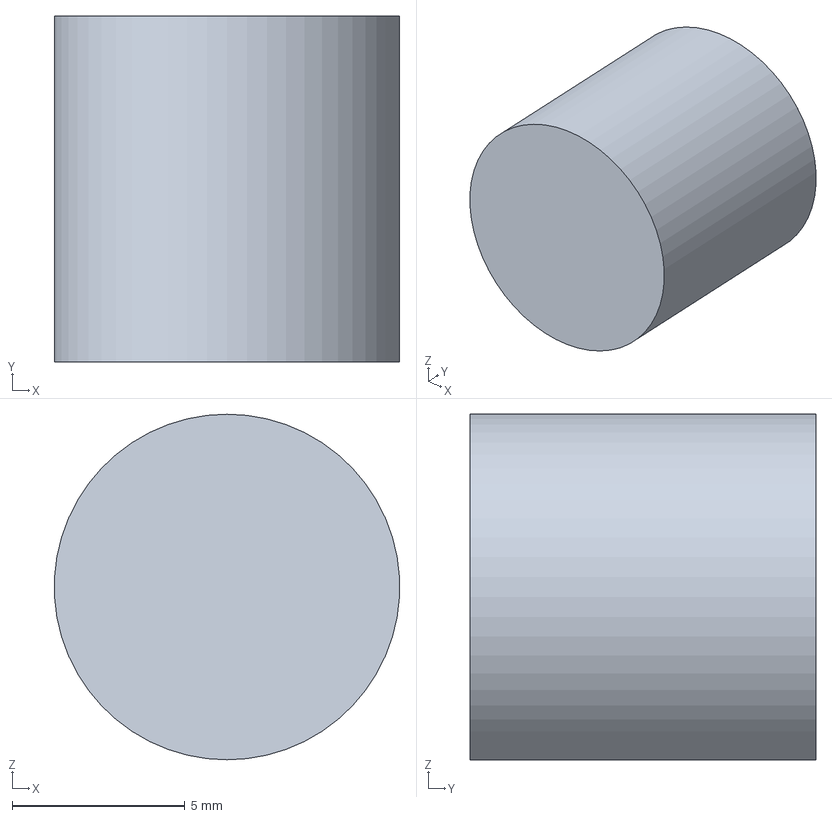
[picture p30: CAD file, 2026-11-13]
cad/parts/Camera_Lens_Envelope.step
9.98 x 10.0 x 10.0 mm
