Umair-Coder124/RoverBuddy-X1-verified/cad/parts/Sensor_Mount_-11.step

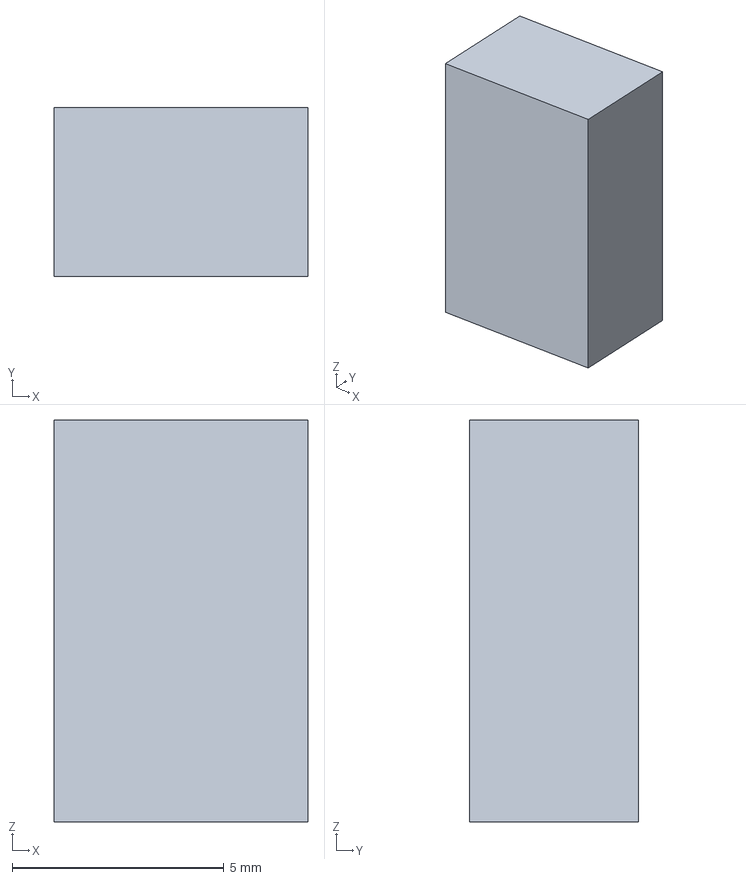
[picture p31: CAD file, 2026-11-13]
cad/parts/Sensor_Mount_-11.step
6.00 x 4.00 x 9.50 mm
