Umair-Coder124/RoverBuddy-X1-verified/cad/parts/09_Obstacle_Sensor_Front_Reference.step

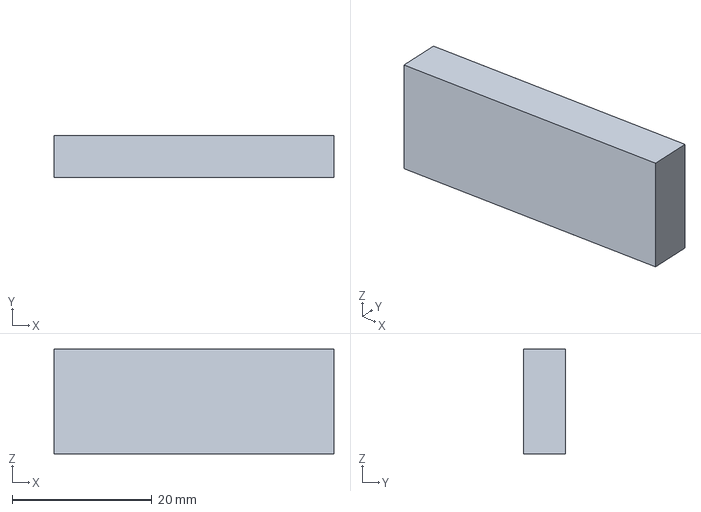
[picture p32: CAD file, 2026-11-13]
cad/parts/09_Obstacle_Sensor_Front_Reference.step
40.0 x 6.00 x 15.0 mm
