Umair-Coder124/RoverBuddy-X1-verified/cad/parts/Controller_Foot.step

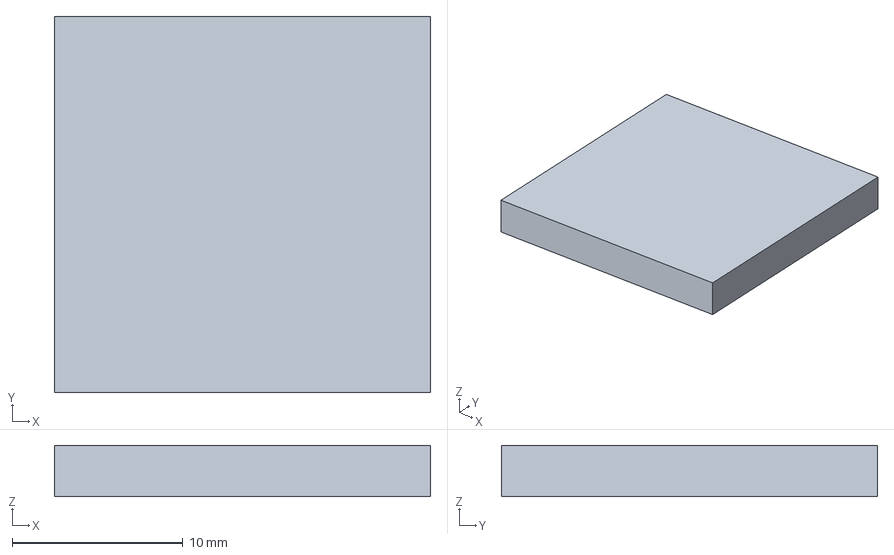
[picture p33: CAD file, 2026-11-13]
cad/parts/Controller_Foot.step
22.0 x 22.0 x 3.00 mm
