Umair-Coder124/RoverBuddy-X1-verified/cad/parts/Pi_Bridge_Standoff_-33_-48.step

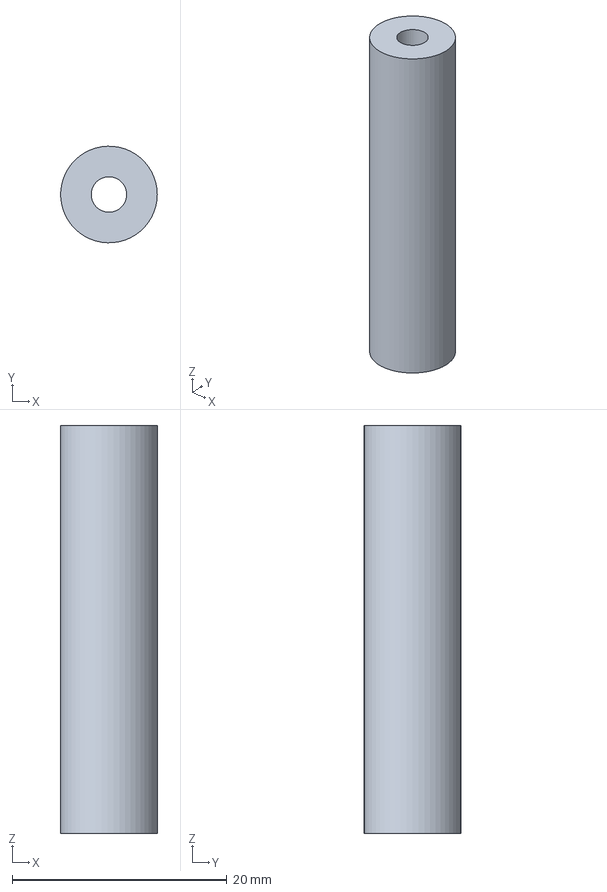
[picture p34: CAD file, 2026-11-13]
cad/parts/Pi_Bridge_Standoff_-33_-48.step
8.99 x 9.00 x 38.0 mm
