Umair-Coder124/RoverBuddy-X1-verified/cad/parts/Battery_Tray_Open_End_With_Strap_Slots.step

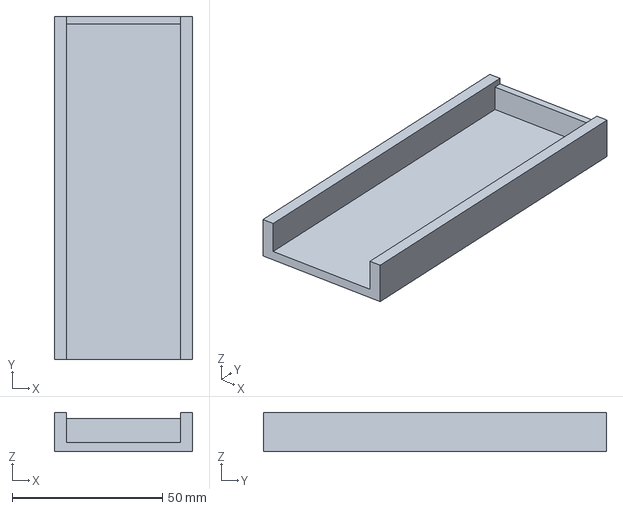
[picture p35: CAD file, 2026-11-13]
cad/parts/Battery_Tray_Open_End_With_Strap_Slots.step
46.0 x 114.0 x 13.0 mm
