Umair-Coder124/RoverBuddy-X1-verified/cad/parts/Roller_Rear_L_01.step

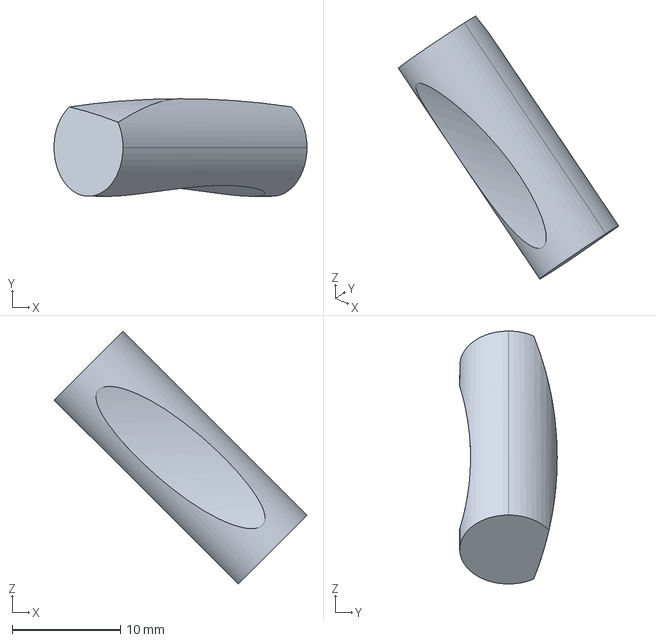
[picture p36: CAD file, 2026-11-13]
cad/parts/Roller_Rear_L_01.step
23.3 x 9.00 x 23.3 mm
