Umair-Coder124/RoverBuddy-X1-verified/cad/parts/Pi5_Board_Envelope.step

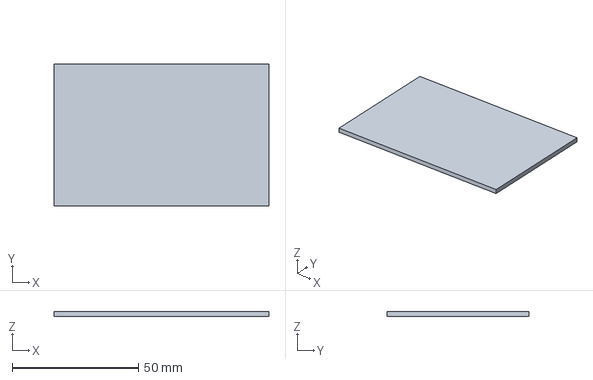
[picture p37: CAD file, 2026-11-13]
cad/parts/Pi5_Board_Envelope.step
85.0 x 56.0 x 2.00 mm
