Umair-Coder124/RoverBuddy-X1-verified/cad/parts/Pan_Servo_Support.step

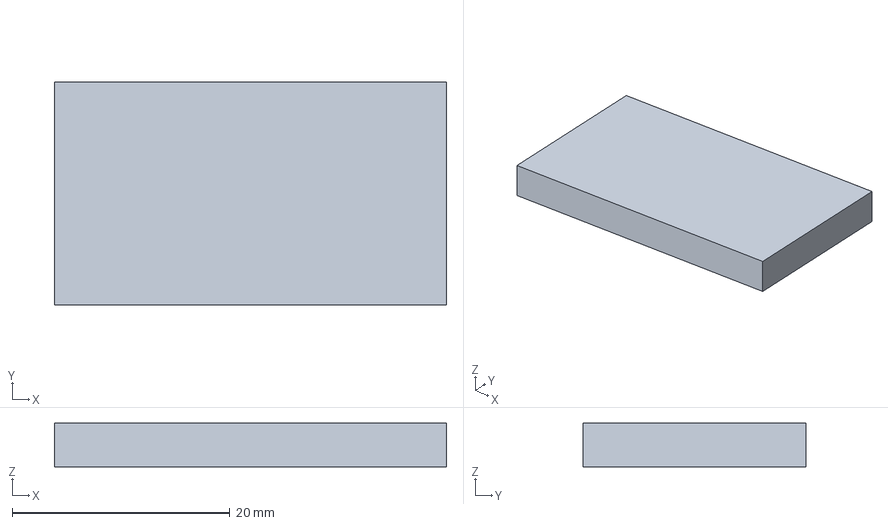
[picture p38: CAD file, 2026-11-13]
cad/parts/Pan_Servo_Support.step
36.0 x 20.5 x 4.00 mm
