Umair-Coder124/RoverBuddy-X1-verified/cad/parts/Cradle_Cap_Post_Rear_L_71.5.step

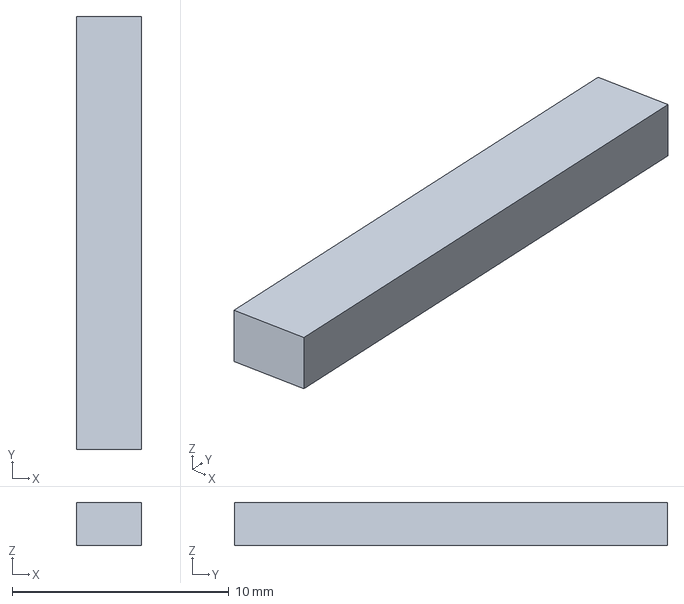
[picture p39: CAD file, 2026-11-13]
cad/parts/Cradle_Cap_Post_Rear_L_71.5.step
3.00 x 20.0 x 2.00 mm
