Umair-Coder124/RoverBuddy-X1-verified/cad/parts/Tilt_Servo_Support.step

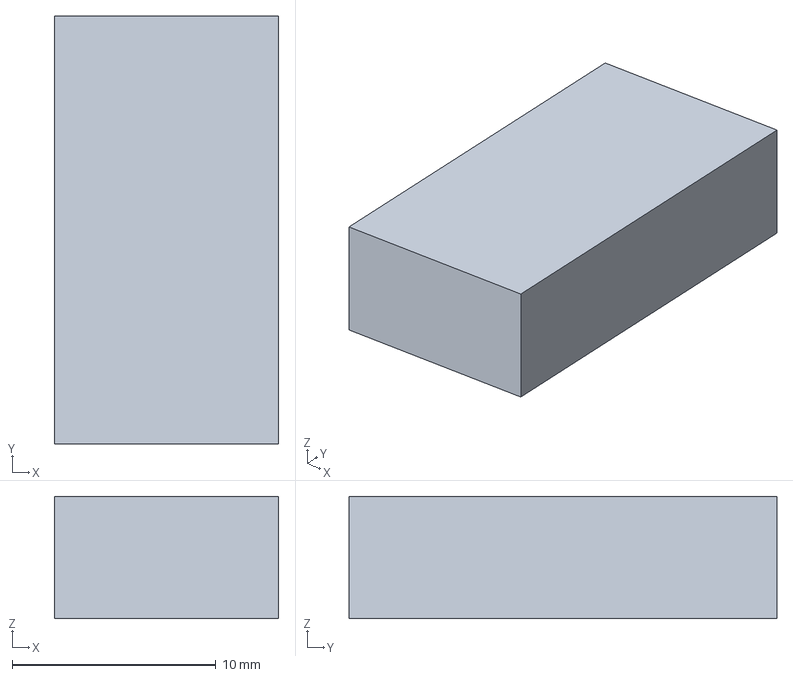
[picture p40: CAD file, 2026-11-13]
cad/parts/Tilt_Servo_Support.step
11.0 x 21.0 x 6.00 mm
