Umair-Coder124/RoverBuddy-X1-verified/cad/parts/Neck_To_Head_Adapter_Plate.step

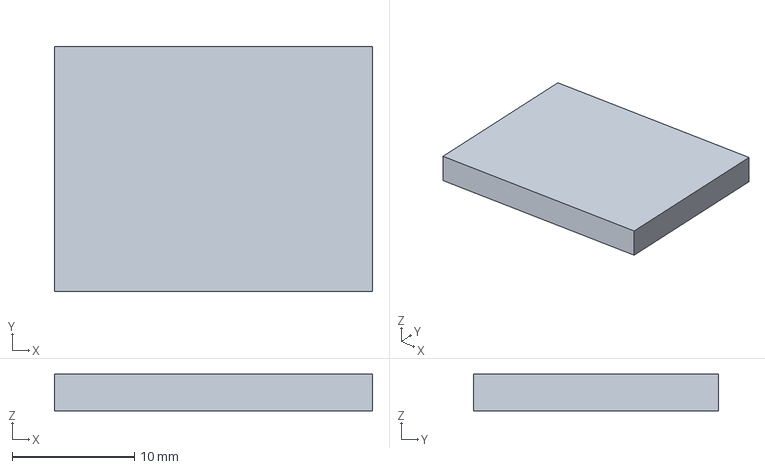
[picture p41: CAD file, 2026-11-13]
cad/parts/Neck_To_Head_Adapter_Plate.step
26.0 x 20.0 x 3.00 mm
