Umair-Coder124/RoverBuddy-X1-verified/cad/parts/Controller_Envelope.step

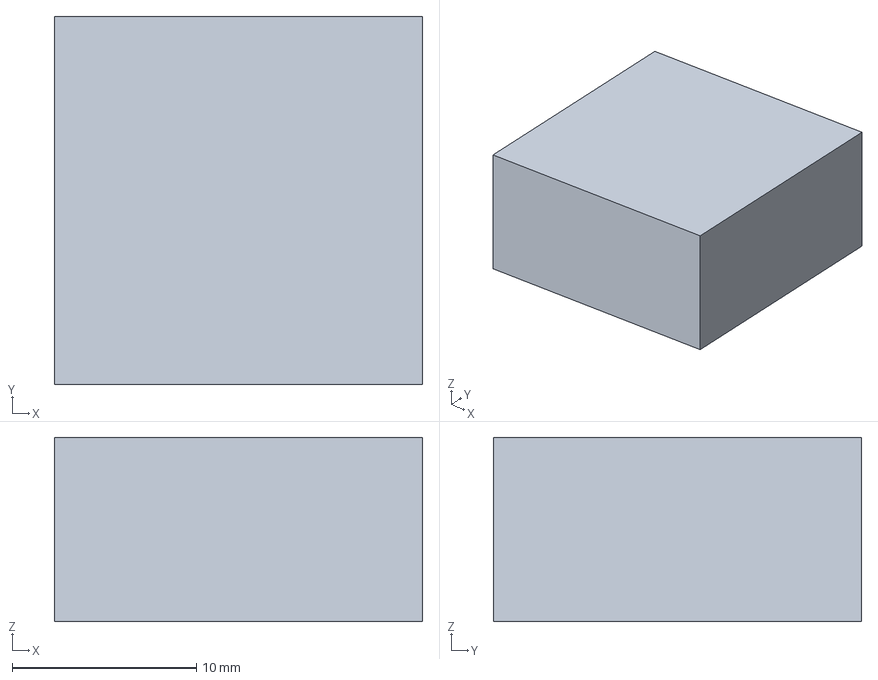
[picture p42: CAD file, 2026-11-13]
cad/parts/Controller_Envelope.step
20.0 x 20.0 x 10.0 mm
