Umair-Coder124/RoverBuddy-X1-verified/cad/parts/Driver_Left_Envelope.step

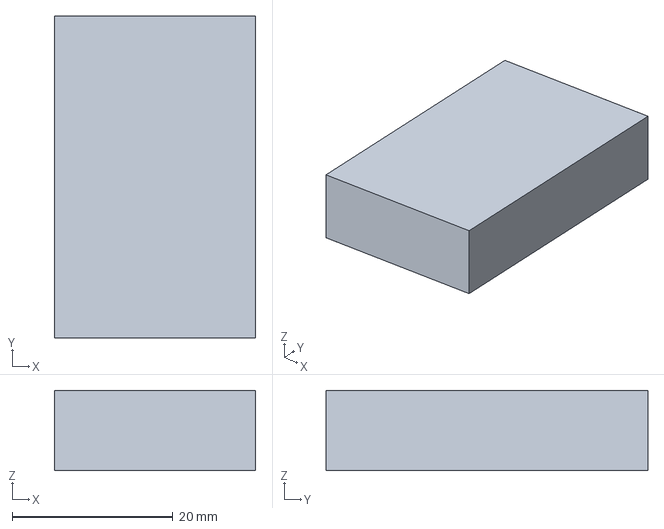
[picture p43: CAD file, 2026-11-13]
cad/parts/Driver_Left_Envelope.step
25.0 x 40.0 x 10.0 mm
