Umair-Coder124/RoverBuddy-X1-verified/cad/parts/Hollow_Head_With_Lens_And_Ribbon_Openings.step

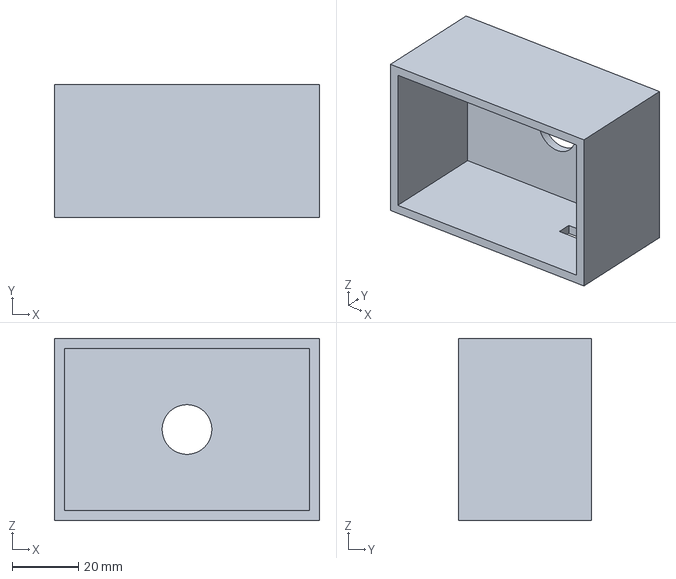
[picture p44: CAD file, 2026-11-13]
cad/parts/Hollow_Head_With_Lens_And_Ribbon_Openings.step
80.0 x 40.0 x 55.0 mm
