Umair-Coder124/RoverBuddy-X1-verified/cad/parts/05_Single_Concept_Gusset_4mm.step

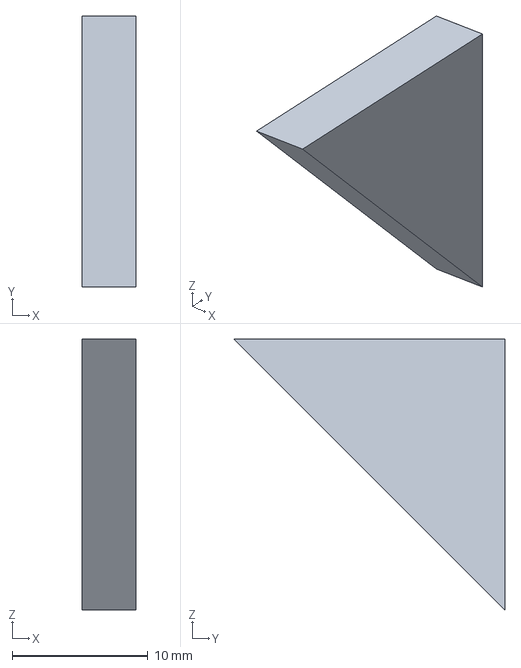
[picture p45: CAD file, 2026-11-13]
cad/parts/05_Single_Concept_Gusset_4mm.step
4.00 x 20.0 x 20.0 mm
