Umair-Coder124/RoverBuddy-X1-verified/cad/parts/04_Neck_Base_Plate_50x35x4.step

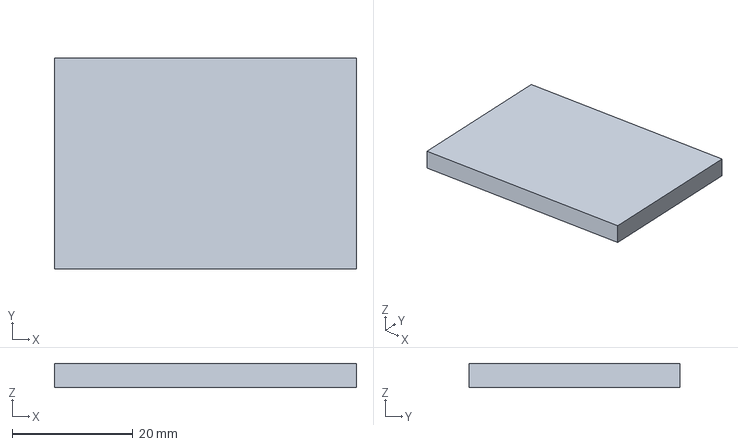
[picture p46: CAD file, 2026-11-13]
cad/parts/04_Neck_Base_Plate_50x35x4.step
50.0 x 35.0 x 4.00 mm
