Umair-Coder124/RoverBuddy-X1-verified/cad/parts/Display_5inch_121x89p48_Envelope.step

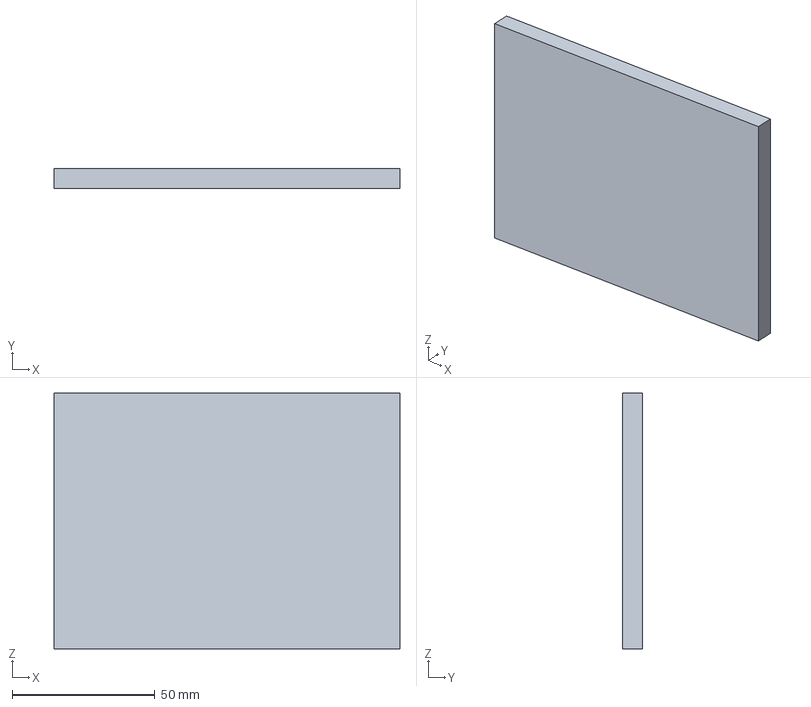
[picture p47: CAD file, 2026-11-13]
cad/parts/Display_5inch_121x89p48_Envelope.step
121.0 x 7.00 x 89.5 mm
