Umair-Coder124/RoverBuddy-X1-verified/cad/parts/Camera_Module_3_PCB_Envelope.step

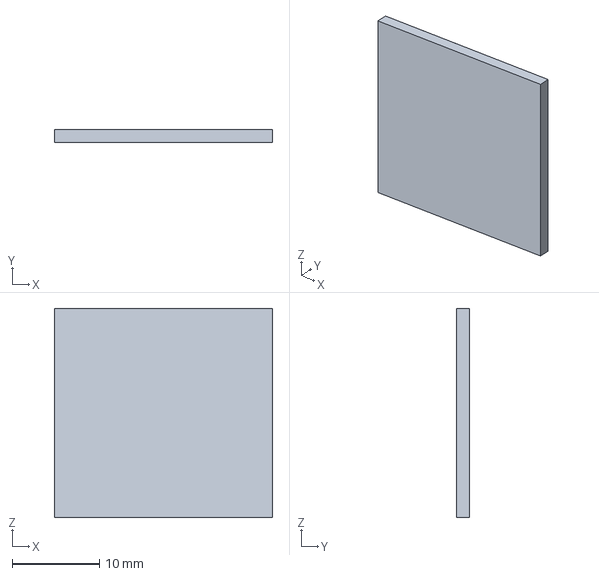
[picture p48: CAD file, 2026-11-13]
cad/parts/Camera_Module_3_PCB_Envelope.step
25.0 x 1.50 x 24.0 mm
