Umair-Coder124/RoverBuddy-X1-verified/cad/parts/Base_Chassis_With_Mount_Holes.step

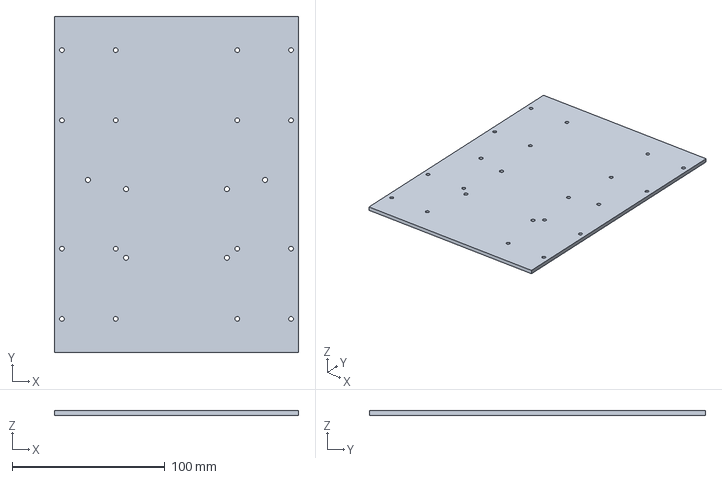
[picture p49: CAD file, 2026-11-13]
cad/parts/Base_Chassis_With_Mount_Holes.step
160.0 x 220.0 x 3.00 mm
