Umair-Coder124/RoverBuddy-X1-verified/cad/parts/Ultrasonic_Transducer_-12.step

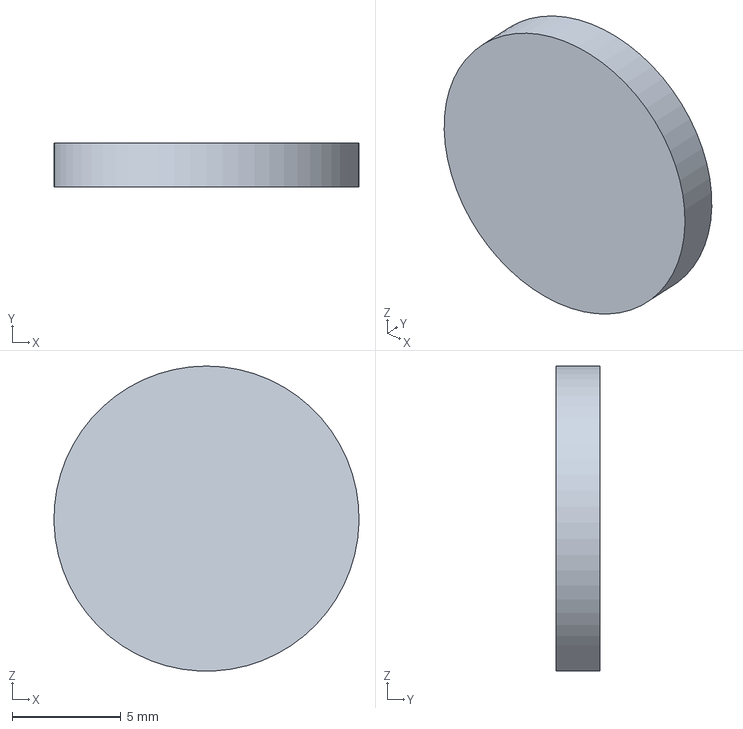
[picture p50: CAD file, 2026-11-13]
cad/parts/Ultrasonic_Transducer_-12.step
14.0 x 2.00 x 14.0 mm
