Umair-Coder124/RoverBuddy-X1-verified/cad/parts/Pan_Servo_Envelope.step

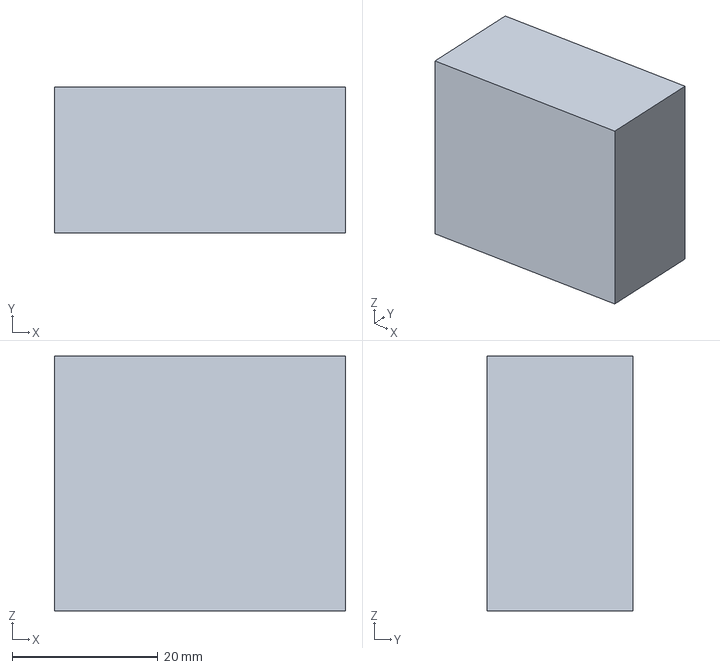
[picture p51: CAD file, 2026-11-13]
cad/parts/Pan_Servo_Envelope.step
40.0 x 20.0 x 35.0 mm
