Umair-Coder124/RoverBuddy-X1-verified/cad/parts/Display_Side_Retainer_-62.5.step

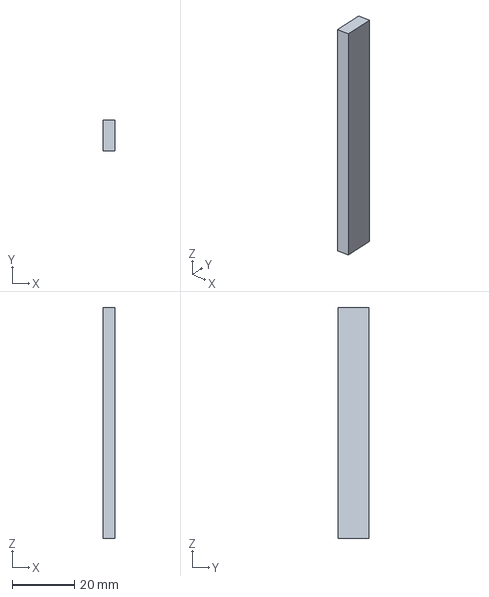
[picture p52: CAD file, 2026-11-13]
cad/parts/Display_Side_Retainer_-62.5.step
4.00 x 10.0 x 74.0 mm
