Umair-Coder124/RoverBuddy-X1-verified/(list of files, cad)

Other CAD files:
cad/parts/Roller_Rear_L_03.step
cad/parts/Roller_Front_R_06.step
cad/parts/Roller_Rear_R_06.step
cad/parts/Roller_Front_R_02.step
cad/parts/Roller_Front_R_07.step
cad/parts/Roller_Rear_L_09.step
cad/parts/Roller_Rear_R_04.step
cad/parts/Pi_Board_Spacer_-33_-3.step
cad/parts/Roller_Front_L_09.step
cad/parts/Motor_Cradle_Cap_Front_L.step
cad/parts/Roller_Front_L_05.step
cad/parts/Motor_Cradle_Front_R.step
cad/parts/Roller_Rear_R_03.step
cad/parts/Mecanum_Wheel_Hub_Rear_L.step
cad/parts/Supplied_Coupling_Reference_Rear_L.step
cad/parts/Motor_3777_Envelope_Rear_R.step
cad/parts/Driver_Right_Foot.step
cad/parts/Motor_Shaft_Reference_Rear_L.step
cad/parts/Roller_Rear_L_05.step
cad/parts/Roller_Front_L_07.step
cad/parts/Roller_Rear_R_08.step
cad/parts/Motor_Cradle_Rear_R.step
cad/parts/Roller_Rear_L_06.step
cad/parts/Motor_Cradle_Cap_Front_R.step
cad/parts/Roller_Rear_R_01.step
cad/parts/Roller_Front_R_09.step
cad/parts/Cradle_Cap_Post_Rear_R_46.5.step
cad/parts/Roller_Rear_R_02.step
cad/parts/Cradle_Cap_Post_Front_R_46.5.step
cad/parts/Motor_3777_Envelope_Rear_L.step
cad/parts/Roller_Front_R_04.step
cad/parts/Roller_Front_R_05.step
cad/parts/Supplied_Coupling_Reference_Front_R.step
cad/parts/Motor_Cradle_Front_L.step
cad/parts/Roller_Front_L_04.step
cad/parts/Motor_Shaft_Reference_Front_L.step
cad/parts/Roller_Front_L_03.step
cad/parts/Motor_Shaft_Reference_Rear_R.step
cad/parts/Mecanum_Wheel_Hub_Front_L.step
cad/parts/Roller_Rear_R_05.step
cad/parts/Supplied_Coupling_Reference_Rear_R.step
cad/parts/Cradle_Cap_Post_Rear_R_71.5.step
cad/parts/Roller_Front_R_01.step
cad/parts/Motor_Cradle_Cap_Rear_R.step
cad/parts/Roller_Front_L_08.step
cad/parts/Pi_Bridge_Standoff_-33_-3.step
cad/parts/Roller_Front_R_08.step
cad/parts/Roller_Rear_L_02.step
cad/parts/Mecanum_Wheel_Hub_Rear_R.step
cad/parts/Motor_3777_Envelope_Front_R.step
cad/parts/Roller_Front_L_01.step
cad/parts/Roller_Rear_L_07.step
cad/parts/Driver_Right_Envelope.step
cad/parts/Cradle_Cap_Post_Rear_L_46.5.step
cad/parts/Cradle_Cap_Post_Front_L_71.5.step
cad/parts/Cradle_Cap_Post_Front_R_71.5.step
cad/parts/Roller_Rear_L_04.step
cad/parts/Cradle_Cap_Post_Front_L_46.5.step
cad/parts/Roller_Front_L_02.step
cad/parts/Chest_Base_Bracket_58.step
cad/parts/Cradle_Base_Screw_Front_L_39.8_42.step
cad/parts/Cradle_Base_Screw_Front_L_39.8_88.step
cad/parts/Cradle_Base_Screw_Front_L_75_42.step
cad/parts/Cradle_Base_Screw_Front_L_75_88.step
cad/parts/Cradle_Base_Screw_Front_R_39.8_42.step
cad/parts/Cradle_Base_Screw_Front_R_39.8_88.step
cad/parts/Cradle_Base_Screw_Front_R_75_42.step
cad/parts/Cradle_Base_Screw_Front_R_75_88.step
cad/parts/Cradle_Base_Screw_Rear_L_39.8_-42.step
cad/parts/Cradle_Base_Screw_Rear_L_39.8_-88.step
cad/parts/Cradle_Base_Screw_Rear_L_75_-42.step
cad/parts/Cradle_Base_Screw_Rear_L_75_-88.step
cad/parts/Cradle_Base_Screw_Rear_R_39.8_-42.step
cad/parts/Cradle_Base_Screw_Rear_R_39.8_-88.step
cad/parts/Cradle_Base_Screw_Rear_R_75_-42.step
cad/parts/Cradle_Base_Screw_Rear_R_75_-88.step
cad/parts/Display_Side_Retainer_62.5.step
cad/parts/Pi_Board_Spacer_33_-3.step
cad/parts/Pi_Board_Spacer_33_-47.step
cad/parts/Pi_Bridge_Standoff_33_-3.step
cad/parts/Pi_Bridge_Standoff_33_-48.step
cad/parts/Sensor_Mount_11.step
cad/parts/Ultrasonic_Transducer_12.step
