Umair-Coder124/RoverBuddy-X1-verified/docs/images/wiring_draft.png

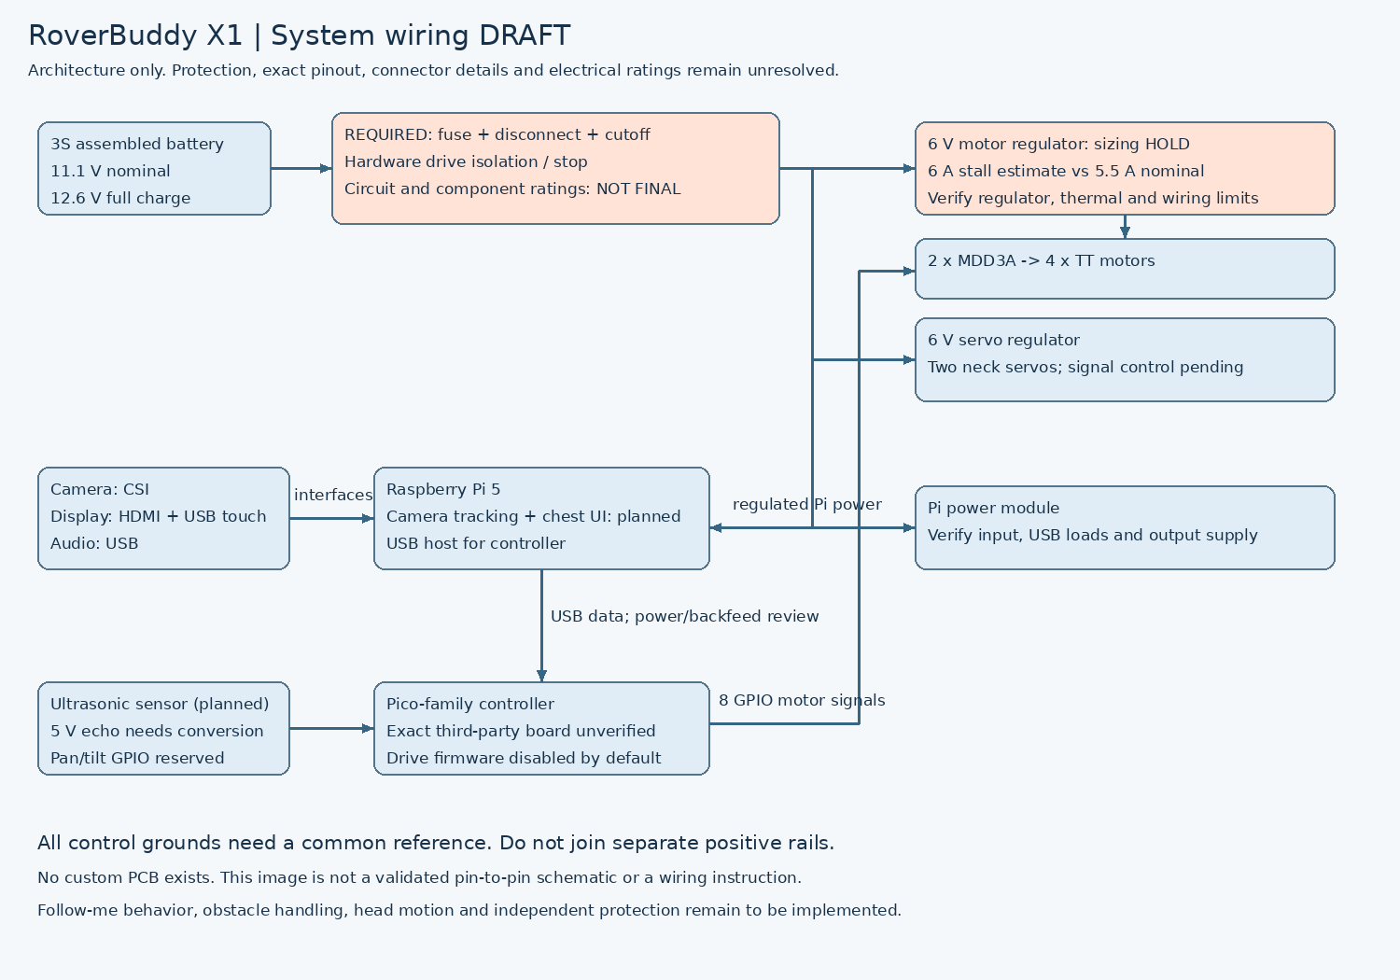
docs/images/wiring_draft.png
