Umair-Coder124/RoverBuddy-X1-verified/(commit log)

2026-11-13 Add RoverBuddy X1 design review files
    [bom.csv]
2026-11-13 Restore project README and CAD folder
    [02_Chest_Panel_140x110x3.step, 04_Neck_Base_Plate_50x35x4.step, 05_Single_Concept_Gusset_4mm.step, 09_Obstacle_Sensor_Front_Reference.step, 10_Neck_Pan_Axis_Bearing_Concept.step, Base_Chassis_With_Mount_Holes.step, Battery_108x35x27_Envelope.step, Battery_Tray_Open_End_With_Strap_Slots.step]
2026-11-13 Update RoverBuddy assembly with repaired wheel rollers
    [Roller_Front_R_03.step, Roller_Rear_L_03.step, RoverBuddy_X1_Detailed_Assembly.step]
2026-11-13 Document Cytron front motor driver connections
2026-11-13 Document Cytron rear motor driver connections
2026-11-13 Update RoverBuddy controller and motor power design
2026-11-14 Document battery protection and motor cutoff design draft
2026-11-14 Align RoverBuddy protection notes and power overview
    [bom.csv]
2026-11-14 Screen battery protection and motor cutoff candidates
2026-11-14 Document servo peak load and wire sizing checks
2026-11-14 Screen documented head servo alternative
2026-11-14 Estimate head tilt torque from CAD
2026-11-14 Shortlist lower-current tilt servo and estimate pan load
2026-11-14 Document CAD camera ribbon route and travel checks
2026-11-14 Estimate camera ribbon length from CAD
2026-11-14 Record pan sweep and mount clearance checks
2026-11-14 Lay out XM430 mount around existing pan axis
2026-11-14 Discard oversized Pico serial frames through newline
2026-11-14 Restore verified TW21 supplier link
    [bom.csv]
2026-11-14 Add candidate supplier links for servo horn and battery pouch
    [bom.csv]
2026-11-14 Exclude unverified optional buzzer from funding estimate
    [bom.csv]
2026-11-14 Record regulator inhibit and cell-monitor findings
2026-11-14 Clarify motor regulator enable polarity
2026-11-14 Screen factory-protected battery alternative
2026-11-14 Record 9 Ah battery CAD fit screening
2026-11-14 Document reference pack charging and spare plan
2026-11-14 Record measured XM/H430 idler assembly dimensions
2026-11-14 Record raised pan clearance and power protection acceptance checks
2026-11-14 Budget an identical spare battery and update provisional total
    [bom.csv]
2026-11-14 Record servo fit dimensions and battery cutoff screening
2026-11-14 Record side-to-side tilt servo packaging check
2026-11-14 Use USD unit prices in Fallen BOM import
    [bom.csv]
